weiweiweiopen/IVcurve_tester/hardware/basic/BOM.csv

Designators | Quantity | Value | Footprint | MPN
R12 | 1 | 100 CANDIDATE | Resistor_SMD:R_2512_6332Metric
C1,C2 | 2 | 100n | Capacitor_SMD:C_0603_1608Metric
R20,R21,R22,R23,R24 | 5 | 10k | Resistor_SMD:R_0603_1608Metric
C3 | 1 | 10n | Capacitor_SMD:C_0603_1608Metric
C4,C5 | 2 | 10u 10V X7R | Capacitor_SMD:C_0805_2012Metric
R11 | 1 | 150 CANDIDATE | Resistor_SMD:R_2512_6332Metric
R1 | 1 | 1M CANDIDATE | Resistor_SMD:R_2512_6332Metric
R17 | 1 | 1k | Resistor_SMD:R_0603_1608Metric
R6 | 1 | 1k CANDIDATE | Resistor_SMD:R_2512_6332Metric
R5 | 1 | 2.2k CANDIDATE | Resistor_SMD:R_2512_6332Metric
R16 | 1 | 20 CANDIDATE | Resistor_SMD:R_2512_6332Metric
R2 | 1 | 20k CANDIDATE | Resistor_SMD:R_2512_6332Metric
R10 | 1 | 220 CANDIDATE | Resistor_SMD:R_2512_6332Metric
R15 | 1 | 30.1 CANDIDATE | Resistor_SMD:R_2512_6332Metric
R9 | 1 | 330 CANDIDATE | Resistor_SMD:R_2512_6332Metric
R4 | 1 | 4.3k CANDIDATE | Resistor_SMD:R_2512_6332Metric
R18,R19 | 2 | 4.7k | Resistor_SMD:R_0603_1608Metric
R8 | 1 | 470 CANDIDATE | Resistor_SMD:R_2512_6332Metric
R14 | 1 | 49.9 CANDIDATE | Resistor_SMD:R_2512_6332Metric
R13 | 1 | 75 CANDIDATE | Resistor_SMD:R_2512_6332Metric
R7 | 1 | 750 CANDIDATE | Resistor_SMD:R_2512_6332Metric
R3 | 1 | 8.2k CANDIDATE | Resistor_SMD:R_2512_6332Metric
U1 | 1 | ADG706BRUZ-REEL7 | Package_SO:TSSOP-28_4.4x9.7mm_P0.65mm | ADG706BRUZ-REEL7
U2 | 1 | ADS1115IDGSR / 0x48 | Package_SO:TSSOP-10_3x3mm_P0.5mm | ADS1115IDGSR
J3 | 1 | Adafruit 4814 SSD1680 250x122 | Marc:Adafruit_4814_FeatherWing_Mating | 4814
J1 | 1 | DSSC single-cell collector | Marc:DSSC_Collector_58mm
A1 | 1 | LOLIN S3 Mini V1.0.0 | Marc:LOLIN_S3_MINI_V1 | LOLIN S3 MINI V1.0.0
SW1 | 1 | MEASURE / SCALE | Button_Switch_SMD:SW_SPST_TL3342 | TL3342候選
