weiweiweiopen/IVcurve_tester/hardware/charging/BOM.csv

Designators | Quantity | Value | Footprint | MPN
C201,C202 | 2 | 1.5F 5V PHB | solar_oracle:PHB_5R0V155_R_LaidDown_Provisional | PHB-5R0V155-R
R283 | 1 | 1.74M | Resistor_SMD:R_1206_3216Metric | TNPW12061M74BEEA
R12 | 1 | 100 CANDIDATE | Resistor_SMD:R_2512_6332Metric
R285,R310,R323 | 3 | 100k | Resistor_SMD:R_0603_1608Metric | RC0603FR-07100KL
C1,C2 | 2 | 100n | Capacitor_SMD:C_0603_1608Metric
C314,C334,C335,C336 | 4 | 100n | Capacitor_SMD:C_0805_2012Metric | GRM21BR71H104KA01L
C309,C310 | 2 | 100u | Capacitor_SMD:C_1210_3225Metric | GRM32ER60J107ME20L
R318 | 1 | 107k | Resistor_SMD:R_0603_1608Metric | RC0603FR-07107KL
R20,R21,R22,R23,R24 | 5 | 10k | Resistor_SMD:R_0603_1608Metric
R322,R320,R321 | 3 | 10k | Resistor_SMD:R_0603_1608Metric | RC0603FR-0710KL
C3 | 1 | 10n | Capacitor_SMD:C_0603_1608Metric
C305,C306,C307,C308,C313 | 5 | 10u | Capacitor_SMD:C_0805_2012Metric | GRM21BR61C106KE15L
C4,C5 | 2 | 10u 10V X7R | Capacitor_SMD:C_0805_2012Metric
L202 | 1 | 10uH | Inductor_SMD:L_TDK_MLZ1608 | MLZ1608N100LT000
R319 | 1 | 124k | Resistor_SMD:R_0603_1608Metric | RC0603FR-07124KL
R282 | 1 | 143k | Resistor_SMD:R_1206_3216Metric | TNPW1206143KBEEA
R11 | 1 | 150 CANDIDATE | Resistor_SMD:R_2512_6332Metric
R311 | 1 | 1M | Resistor_SMD:R_0603_1608Metric | RC0603FR-071ML
R1 | 1 | 1M CANDIDATE | Resistor_SMD:R_2512_6332Metric
D201 | 1 | 1N4148W / FLYBACK | Diode_SMD:D_SOD-123 | 1N4148W-7-F
R17 | 1 | 1k | Resistor_SMD:R_0603_1608Metric
R290 | 1 | 1k | Resistor_SMD:R_0603_1608Metric | RC0603FR-071KL
R6 | 1 | 1k CANDIDATE | Resistor_SMD:R_2512_6332Metric
C332,C333 | 2 | 1u | Capacitor_SMD:C_0805_2012Metric | GRM21BR71C105KA01L
C317 | 1 | 1uF 10V X7R | Capacitor_SMD:C_0603_1608Metric | TBD_1uF_10V_X7R_0603
L203 | 1 | 1uH | solar_oracle:Coilcraft_XEL4030 | XEL4030-102MEC
R5 | 1 | 2.2k CANDIDATE | Resistor_SMD:R_2512_6332Metric
R2 | 1 | 20k CANDIDATE | Resistor_SMD:R_2512_6332Metric
R10 | 1 | 220 CANDIDATE | Resistor_SMD:R_2512_6332Metric
C312 | 1 | 220p | Capacitor_SMD:C_0603_1608Metric | GRM1885C1H221JA01D
C304,C311,C315,C316 | 4 | 22u | Capacitor_SMD:C_1210_3225Metric | GRM32ER61A226KE20L
L201 | 1 | 22uH | Inductor_SMD:L_Coilcraft_LPS4018 | LPS4018-223MRC
R9 | 1 | 330 CANDIDATE | Resistor_SMD:R_2512_6332Metric
R4 | 1 | 4.3k CANDIDATE | Resistor_SMD:R_2512_6332Metric
R18,R19 | 2 | 4.7k | Resistor_SMD:R_0603_1608Metric
R8 | 1 | 470 CANDIDATE | Resistor_SMD:R_2512_6332Metric
R291,R286 | 2 | 47k | Resistor_SMD:R_0603_1608Metric | RC0603FR-0747KL
R280 | 1 | 549k | Resistor_SMD:R_1206_3216Metric | TNPW1206549KBEEA
R16 | 1 | 56 CANDIDATE | Resistor_SMD:R_2512_6332Metric
R15 | 1 | 62 CANDIDATE | Resistor_SMD:R_2512_6332Metric
R14 | 1 | 68 CANDIDATE | Resistor_SMD:R_2512_6332Metric
R284 | 1 | 732k | Resistor_SMD:R_0603_1608Metric | RC0603FR-07732KL
R13 | 1 | 75 CANDIDATE | Resistor_SMD:R_2512_6332Metric
R7 | 1 | 750 CANDIDATE | Resistor_SMD:R_2512_6332Metric
R3 | 1 | 8.2k CANDIDATE | Resistor_SMD:R_2512_6332Metric
R281 | 1 | 9.31k | Resistor_SMD:R_1206_3216Metric | TNPW12069K31BEEA
U1 | 1 | ADG706BRUZ-REEL7 | Package_SO:TSSOP-28_4.4x9.7mm_P0.65mm | ADG706BRUZ-REEL7
U2 | 1 | ADS1115IDGSR / 0x48 | Package_SO:TSSOP-10_3x3mm_P0.5mm | ADS1115IDGSR
U207 | 1 | AEM10941 / CFG=000 | solar_oracle:AEM10941_QFN28_EP3.5 | 10AEM10941C0001
Q217 | 1 | AO3400A / RELAY COIL | Package_TO_SOT_SMD:SOT-23 | AO3400A
Q218 | 1 | AO3400A / WARN LEVEL | Package_TO_SOT_SMD:SOT-23 | AO3400A
J3 | 1 | Adafruit 4814 SSD1680 250x122 | Marc:Adafruit_4814_FeatherWing_Mating | 4814
JP201 | 1 | C&K OS102011MA1QN1 | Button_Switch_THT:SW_Slide_SPDT_Angled_CK_OS102011MA1Q | OS102011MA1QN1
J1 | 1 | DSSC single-cell collector | Marc:DSSC_Collector_58mm
K1 | 1 | G6K-2F-Y DC5 | solar_oracle:G6K_2F_Y | G6K-2F-Y-TR DC5
A1 | 1 | LOLIN S3 Mini V1.0.0 | Marc:LOLIN_S3_MINI_V1 | LOLIN S3 MINI V1.0.0
SW1 | 1 | MEASURE / SCALE | Button_Switch_SMD:SW_SPST_TL3342 | TL3342候選
U213 | 1 | SN74LVC1G17DCKR / DONE ISOLATION | Package_TO_SOT_SMD:SOT-353_SC-70-5 | SN74LVC1G17DCKR
U212 | 1 | SN74LVC1G97DCKR / SCHMITT AND | Package_TO_SOT_SMD:SOT-363_SC-70-6 | SN74LVC1G97DCKR
U211 | 1 | TPL5111DDCR / 600s | Package_TO_SOT_SMD:SOT-23-6 | TPL5111DDCR
U214 | 1 | TPS22917DBV | Package_TO_SOT_SMD:SOT-23-6 | TPS22917DBVR
U208 | 1 | TPS61023DRLR / 5V | Package_TO_SOT_SMD:SOT-563 | TPS61023DRLR
U210 | 1 | TPS7A0233PDBVR / AON ONLY | Package_TO_SOT_SMD:SOT-23-5 | TPS7A0233PDBVR
