weiweiweiopen/IVcurve_tester/hardware/basic/checks/pin-map.csv

Reference | Pin | Net
C3 | 1 | ADC_IN
R17 | 2 | ADC_IN
U2 | 4 | ADC_IN
A1 | J3.4 | BUTTON_N
R21 | 2 | BUTTON_N
SW1 | 1 | BUTTON_N
J1 | 1 | DUT_P
R1 | 1 | DUT_P
R10 | 1 | DUT_P
R11 | 1 | DUT_P
R12 | 1 | DUT_P
R13 | 1 | DUT_P
R14 | 1 | DUT_P
R15 | 1 | DUT_P
R16 | 1 | DUT_P
R17 | 1 | DUT_P
R2 | 1 | DUT_P
R3 | 1 | DUT_P
R4 | 1 | DUT_P
R5 | 1 | DUT_P
R6 | 1 | DUT_P
R7 | 1 | DUT_P
R8 | 1 | DUT_P
R9 | 1 | DUT_P
A1 | J4.2 | EPD_CS
J3 | 21 | EPD_CS
R23 | 2 | EPD_CS
A1 | J4.3 | EPD_DC
J3 | 22 | EPD_DC
A1 | J3.7 | GND
A1 | J4.7 | GND
C1 | 2 | GND
C2 | 2 | GND
C3 | 2 | GND
C4 | 2 | GND
C5 | 2 | GND
J1 | 2 | GND
J3 | 4 | GND
R20 | 2 | GND
SW1 | 2 | GND
U1 | 12 | GND
U1 | 27 | GND
U1 | 28 | GND
U2 | 1 | GND
U2 | 3 | GND
U2 | 5 | GND
U2 | 6 | GND
U2 | 7 | GND
A1 | J5.7 | I2C_SCL
R19 | 2 | I2C_SCL
U2 | 10 | I2C_SCL
A1 | J5.6 | I2C_SDA
R18 | 2 | I2C_SDA
U2 | 9 | I2C_SDA
R1 | 2 | LOAD_00
U1 | 19 | LOAD_00
R2 | 2 | LOAD_01
U1 | 20 | LOAD_01
R3 | 2 | LOAD_02
U1 | 21 | LOAD_02
R4 | 2 | LOAD_03
U1 | 22 | LOAD_03
R5 | 2 | LOAD_04
U1 | 23 | LOAD_04
R6 | 2 | LOAD_05
U1 | 24 | LOAD_05
R7 | 2 | LOAD_06
U1 | 25 | LOAD_06
R8 | 2 | LOAD_07
U1 | 26 | LOAD_07
R9 | 2 | LOAD_08
U1 | 11 | LOAD_08
R10 | 2 | LOAD_09
U1 | 10 | LOAD_09
R11 | 2 | LOAD_10
U1 | 9 | LOAD_10
R12 | 2 | LOAD_11
U1 | 8 | LOAD_11
R13 | 2 | LOAD_12
U1 | 7 | LOAD_12
R14 | 2 | LOAD_13
U1 | 6 | LOAD_13
R15 | 2 | LOAD_14
U1 | 5 | LOAD_14
R16 | 2 | LOAD_15
U1 | 4 | LOAD_15
A1 | J2.8 | MCU_3V3
C1 | 1 | MCU_3V3
C2 | 1 | MCU_3V3
C4 | 1 | MCU_3V3
J3 | 2 | MCU_3V3
R18 | 1 | MCU_3V3
R19 | 1 | MCU_3V3
R21 | 1 | MCU_3V3
R22 | 1 | MCU_3V3
R23 | 1 | MCU_3V3
R24 | 1 | MCU_3V3
U1 | 1 | MCU_3V3
U2 | 8 | MCU_3V3
A1 | J2.2 | MUX_A0
U1 | 17 | MUX_A0
A1 | J5.4 | MUX_A1
U1 | 16 | MUX_A1
A1 | J2.3 | MUX_A2
U1 | 15 | MUX_A2
A1 | J5.3 | MUX_A3
U1 | 14 | MUX_A3
A1 | J5.8 | MUX_EN
R20 | 1 | MUX_EN
U1 | 18 | MUX_EN
J3 | 19 | SD_CS_N
R22 | 2 | SD_CS_N
A1 | J3.5 | SPI_MISO
J3 | 13 | SPI_MISO
A1 | J3.6 | SPI_MOSI
J3 | 12 | SPI_MOSI
A1 | J3.3 | SPI_SCK
J3 | 11 | SPI_SCK
A1 | J4.4 | SRAM_CS
J3 | 20 | SRAM_CS
R24 | 2 | SRAM_CS
A1 | J3.8 | USB_5V
C5 | 1 | USB_5V
A1 | J2.1 | unconnected-(A1-EN-PadJ2.1)
A1 | J5.1 | unconnected-(A1-GPIO1-PadJ5.1)
A1 | J5.2 | unconnected-(A1-GPIO3-PadJ5.2)
A1 | J5.5 | unconnected-(A1-GPIO7-PadJ5.5)
A1 | J2.7 | unconnected-(A1-GPIO10-PadJ2.7)
A1 | J2.6 | unconnected-(A1-GPIO11-PadJ2.6)
A1 | J2.4 | unconnected-(A1-GPIO12-PadJ2.4)
A1 | J2.5 | unconnected-(A1-GPIO13-PadJ2.5)
A1 | J4.8 | unconnected-(A1-GPIO15-PadJ4.8)
A1 | J4.6 | unconnected-(A1-GPIO17-PadJ4.6)
A1 | J4.5 | unconnected-(A1-GPIO21-PadJ4.5)
A1 | J4.1 | unconnected-(A1-GPIO33-PadJ4.1)
A1 | J3.1 | unconnected-(A1-GPIO43-PadJ3.1)
A1 | J3.2 | unconnected-(A1-GPIO44-PadJ3.2)
J3 | 5 | unconnected-(J3-A0-Pad5)
J3 | 6 | unconnected-(J3-A1-Pad6)
J3 | 7 | unconnected-(J3-A2-Pad7)
J3 | 8 | unconnected-(J3-A3-Pad8)
J3 | 9 | unconnected-(J3-A4-Pad9)
J3 | 10 | unconnected-(J3-A5-Pad10)
J3 | 3 | unconnected-(J3-AREF-Pad3)
J3 | 23 | unconnected-(J3-D11-Pad23)
J3 | 24 | unconnected-(J3-D12-Pad24)
J3 | 25 | unconnected-(J3-D13-Pad25)
J3 | 27 | unconnected-(J3-EN_NC-Pad27)
J3 | 16 | unconnected-(J3-GPIO-Pad16)
J3 | 1 | unconnected-(J3-RESET_AUTO-Pad1)
J3 | 14 | unconnected-(J3-RX-Pad14)
J3 | 18 | unconnected-(J3-SCL-Pad18)
J3 | 17 | unconnected-(J3-SDA-Pad17)
J3 | 15 | unconnected-(J3-TX-Pad15)
J3 | 26 | unconnected-(J3-USB_NC-Pad26)
J3 | 28 | unconnected-(J3-VBAT_NC-Pad28)
U1 | 2 | unconnected-(U1-NC-Pad2)
U1 | 3 | unconnected-(U1-NC-Pad3)
U1 | 13 | unconnected-(U1-NC-Pad13)
U2 | 2 | unconnected-(U2-ALERT_RDY-Pad2)
