weiweiweiopen/IVcurve_tester/hardware/charging/checks/pin-map.csv

Reference | Pin | Net
C3 | 1 | ADC_IN
R17 | 2 | ADC_IN
U2 | 4 | ADC_IN
C333 | 1 | AON_3V3
C334 | 1 | AON_3V3
C335 | 1 | AON_3V3
C336 | 1 | AON_3V3
U210 | 5 | AON_3V3
U211 | 1 | AON_3V3
U211 | 6 | AON_3V3
U212 | 5 | AON_3V3
U213 | 5 | AON_3V3
R322 | 1 | BOOST_EN
U208 | 2 | BOOST_EN
U212 | 4 | BOOST_EN
A1 | J3.4 | BUTTON_N
R21 | 2 | BUTTON_N
SW1 | 1 | BUTTON_N
J1 | 1 | DUT_P
K1 | 3 | DUT_P
K1 | 6 | DUT_P
A1 | J4.2 | EPD_CS
J3 | 21 | EPD_CS
R23 | 2 | EPD_CS
A1 | J4.3 | EPD_DC
J3 | 22 | EPD_DC
A1 | J3.7 | GND
A1 | J4.7 | GND
C1 | 2 | GND
C2 | 2 | GND
C201 | 2 | GND
C202 | 2 | GND
C3 | 2 | GND
C304 | 2 | GND
C305 | 2 | GND
C306 | 2 | GND
C307 | 2 | GND
C308 | 2 | GND
C309 | 2 | GND
C310 | 2 | GND
C311 | 2 | GND
C313 | 2 | GND
C314 | 2 | GND
C315 | 2 | GND
C316 | 2 | GND
C317 | 2 | GND
C332 | 2 | GND
C333 | 2 | GND
C334 | 2 | GND
C335 | 2 | GND
C336 | 2 | GND
C4 | 2 | GND
C5 | 2 | GND
J1 | 2 | GND
J3 | 4 | GND
JP201 | 3 | GND
Q217 | 2 | GND
Q218 | 2 | GND
R20 | 2 | GND
R280 | 2 | GND
R285 | 2 | GND
R286 | 2 | GND
R291 | 2 | GND
R311 | 2 | GND
R318 | 2 | GND
R319 | 2 | GND
R320 | 2 | GND
R321 | 2 | GND
R322 | 2 | GND
R323 | 2 | GND
SW1 | 2 | GND
U1 | 12 | GND
U1 | 27 | GND
U1 | 28 | GND
U2 | 1 | GND
U2 | 3 | GND
U2 | 5 | GND
U2 | 6 | GND
U2 | 7 | GND
U207 | 10 | GND
U207 | 12 | GND
U207 | 15 | GND
U207 | 17 | GND
U207 | 18 | GND
U207 | 29 | GND
U207 | 4 | GND
U207 | 5 | GND
U207 | 6 | GND
U207 | 7 | GND
U207 | 8 | GND
U207 | 9 | GND
U208 | 4 | GND
U210 | 2 | GND
U211 | 2 | GND
U212 | 1 | GND
U212 | 2 | GND
U213 | 3 | GND
U214 | 2 | GND
K1 | 2 | HARV_P
U207 | 25 | HARV_P
U207 | 26 | HARV_P
A1 | J5.7 | I2C_SCL
R19 | 2 | I2C_SCL
U2 | 10 | I2C_SCL
A1 | J5.6 | I2C_SDA
R18 | 2 | I2C_SDA
U2 | 9 | I2C_SDA
R1 | 2 | LOAD_00
U1 | 19 | LOAD_00
R2 | 2 | LOAD_01
U1 | 20 | LOAD_01
R3 | 2 | LOAD_02
U1 | 21 | LOAD_02
R4 | 2 | LOAD_03
U1 | 22 | LOAD_03
R5 | 2 | LOAD_04
U1 | 23 | LOAD_04
R6 | 2 | LOAD_05
U1 | 24 | LOAD_05
R7 | 2 | LOAD_06
U1 | 25 | LOAD_06
R8 | 2 | LOAD_07
U1 | 26 | LOAD_07
R9 | 2 | LOAD_08
U1 | 11 | LOAD_08
R10 | 2 | LOAD_09
U1 | 10 | LOAD_09
R11 | 2 | LOAD_10
U1 | 9 | LOAD_10
R12 | 2 | LOAD_11
U1 | 8 | LOAD_11
R13 | 2 | LOAD_12
U1 | 7 | LOAD_12
R14 | 2 | LOAD_13
U1 | 6 | LOAD_13
R15 | 2 | LOAD_14
U1 | 5 | LOAD_14
R16 | 2 | LOAD_15
U1 | 4 | LOAD_15
K1 | 4 | LOAD_P
R1 | 1 | LOAD_P
R10 | 1 | LOAD_P
R11 | 1 | LOAD_P
R12 | 1 | LOAD_P
R13 | 1 | LOAD_P
R14 | 1 | LOAD_P
R15 | 1 | LOAD_P
R16 | 1 | LOAD_P
R2 | 1 | LOAD_P
R3 | 1 | LOAD_P
R4 | 1 | LOAD_P
R5 | 1 | LOAD_P
R6 | 1 | LOAD_P
R7 | 1 | LOAD_P
R8 | 1 | LOAD_P
R9 | 1 | LOAD_P
A1 | J2.8 | MCU_3V3
C1 | 1 | MCU_3V3
C2 | 1 | MCU_3V3
C4 | 1 | MCU_3V3
J3 | 2 | MCU_3V3
R18 | 1 | MCU_3V3
R19 | 1 | MCU_3V3
R21 | 1 | MCU_3V3
R22 | 1 | MCU_3V3
R23 | 1 | MCU_3V3
R24 | 1 | MCU_3V3
R310 | 2 | MCU_3V3
U1 | 1 | MCU_3V3
U2 | 8 | MCU_3V3
A1 | J2.5 | MCU_DONE
R320 | 1 | MCU_DONE
U213 | 2 | MCU_DONE
A1 | J3.8 | MODULE_VBUS
C5 | 1 | MODULE_VBUS
D201 | 1 | MODULE_VBUS
K1 | 1 | MODULE_VBUS
U214 | 6 | MODULE_VBUS
A1 | J2.2 | MUX_A0
U1 | 17 | MUX_A0
A1 | J5.4 | MUX_A1
U1 | 16 | MUX_A1
A1 | J2.3 | MUX_A2
U1 | 15 | MUX_A2
A1 | J5.3 | MUX_A3
U1 | 14 | MUX_A3
A1 | J5.8 | MUX_EN
R20 | 1 | MUX_EN
U1 | 18 | MUX_EN
C312 | 2 | P5_FB
R284 | 2 | P5_FB
R285 | 1 | P5_FB
U208 | 1 | P5_FB
L203 | 2 | P5_SW
U208 | 5 | P5_SW
C304 | 1 | PM_BOOST
R283 | 1 | PM_BOOST
U207 | 1 | PM_BOOST
C306 | 1 | PM_BUCK
L202 | 2 | PM_BUCK
U207 | 3 | PM_BUCK
C305 | 1 | PM_BUFSRC
L201 | 1 | PM_BUFSRC
U207 | 27 | PM_BUFSRC
C308 | 1 | PM_HVOUT
U207 | 14 | PM_HVOUT
C307 | 1 | PM_LVOUT
U207 | 11 | PM_LVOUT
R286 | 1 | PM_READY
U207 | 21 | PM_READY
U212 | 3 | PM_READY
L201 | 2 | PM_SWBOOST
U207 | 28 | PM_SWBOOST
L202 | 1 | PM_SWBUCK
U207 | 2 | PM_SWBUCK
Q218 | 1 | PM_WARN
R311 | 1 | PM_WARN
U207 | 20 | PM_WARN
A1 | J2.6 | POWER_WARN_N
Q218 | 3 | POWER_WARN_N
R310 | 1 | POWER_WARN_N
D201 | 2 | RELAY_COIL_LOW
K1 | 8 | RELAY_COIL_LOW
Q217 | 3 | RELAY_COIL_LOW
Q217 | 1 | SCAN_GATE
R290 | 2 | SCAN_GATE
R291 | 1 | SCAN_GATE
A1 | J2.4 | SCAN_MODE
R290 | 1 | SCAN_MODE
J3 | 19 | SD_CS_N
R22 | 2 | SD_CS_N
K1 | 5 | SENSE_P
R17 | 1 | SENSE_P
R281 | 1 | SET_CHRDY
R282 | 2 | SET_CHRDY
U207 | 23 | SET_CHRDY
R280 | 1 | SET_OVCH
R281 | 2 | SET_OVCH
U207 | 22 | SET_OVCH
R282 | 1 | SET_OVDIS
R283 | 2 | SET_OVDIS
U207 | 24 | SET_OVDIS
C312 | 1 | SOLAR_5V
C315 | 1 | SOLAR_5V
C316 | 1 | SOLAR_5V
C317 | 1 | SOLAR_5V
JP201 | 1 | SOLAR_5V
R284 | 1 | SOLAR_5V
R323 | 1 | SOLAR_5V
U208 | 6 | SOLAR_5V
U214 | 1 | SOLAR_5V
JP201 | 2 | SOLAR_EN
U214 | 3 | SOLAR_EN
A1 | J3.5 | SPI_MISO
J3 | 13 | SPI_MISO
A1 | J3.6 | SPI_MOSI
J3 | 12 | SPI_MOSI
A1 | J3.3 | SPI_SCK
J3 | 11 | SPI_SCK
A1 | J4.4 | SRAM_CS
J3 | 20 | SRAM_CS
R24 | 2 | SRAM_CS
R318 | 1 | TIMER_DELAY
R319 | 1 | TIMER_DELAY
U211 | 3 | TIMER_DELAY
R321 | 1 | TIMER_DONE
U211 | 4 | TIMER_DONE
U213 | 4 | TIMER_DONE
U211 | 5 | TIMER_REQUEST
U212 | 6 | TIMER_REQUEST
C201 | 1 | VSTORE
C202 | 1 | VSTORE
C309 | 1 | VSTORE
C310 | 1 | VSTORE
C311 | 1 | VSTORE
C313 | 1 | VSTORE
C314 | 1 | VSTORE
C332 | 1 | VSTORE
L203 | 1 | VSTORE
U207 | 16 | VSTORE
U208 | 3 | VSTORE
U210 | 1 | VSTORE
U210 | 3 | VSTORE
A1 | J2.1 | unconnected-(A1-EN-PadJ2.1)
A1 | J5.1 | unconnected-(A1-GPIO1-PadJ5.1)
A1 | J5.2 | unconnected-(A1-GPIO3-PadJ5.2)
A1 | J5.5 | unconnected-(A1-GPIO7-PadJ5.5)
A1 | J2.7 | unconnected-(A1-GPIO10-PadJ2.7)
A1 | J4.8 | unconnected-(A1-GPIO15-PadJ4.8)
A1 | J4.6 | unconnected-(A1-GPIO17-PadJ4.6)
A1 | J4.5 | unconnected-(A1-GPIO21-PadJ4.5)
A1 | J4.1 | unconnected-(A1-GPIO33-PadJ4.1)
A1 | J3.1 | unconnected-(A1-GPIO43-PadJ3.1)
A1 | J3.2 | unconnected-(A1-GPIO44-PadJ3.2)
J3 | 5 | unconnected-(J3-A0-Pad5)
J3 | 6 | unconnected-(J3-A1-Pad6)
J3 | 7 | unconnected-(J3-A2-Pad7)
J3 | 8 | unconnected-(J3-A3-Pad8)
J3 | 9 | unconnected-(J3-A4-Pad9)
J3 | 10 | unconnected-(J3-A5-Pad10)
J3 | 3 | unconnected-(J3-AREF-Pad3)
J3 | 23 | unconnected-(J3-D11-Pad23)
J3 | 24 | unconnected-(J3-D12-Pad24)
J3 | 25 | unconnected-(J3-D13-Pad25)
J3 | 27 | unconnected-(J3-EN_NC-Pad27)
J3 | 16 | unconnected-(J3-GPIO-Pad16)
J3 | 1 | unconnected-(J3-RESET_AUTO-Pad1)
J3 | 14 | unconnected-(J3-RX-Pad14)
J3 | 18 | unconnected-(J3-SCL-Pad18)
J3 | 17 | unconnected-(J3-SDA-Pad17)
J3 | 15 | unconnected-(J3-TX-Pad15)
J3 | 26 | unconnected-(J3-USB_NC-Pad26)
J3 | 28 | unconnected-(J3-VBAT_NC-Pad28)
K1 | 7 | unconnected-(K1-NC_B-Pad7)
U1 | 2 | unconnected-(U1-NC-Pad2)
U1 | 3 | unconnected-(U1-NC-Pad3)
U1 | 13 | unconnected-(U1-NC-Pad13)
U2 | 2 | unconnected-(U2-ALERT_RDY-Pad2)
U207 | 13 | unconnected-(U207-FB_HV-Pad13)
U207 | 19 | unconnected-(U207-STATUS2-Pad19)
U210 | 4 | unconnected-(U210-NC-Pad4)
U213 | 1 | unconnected-(U213-NC-Pad1)
U214 | 4 | unconnected-(U214-CT-Pad4)
U214 | 5 | unconnected-(U214-QOD-Pad5)
