weiweiweiopen/IVcurve_tester/hardware/charging/models/Relay_DPDT_Omron_G6K-2F-Y.step

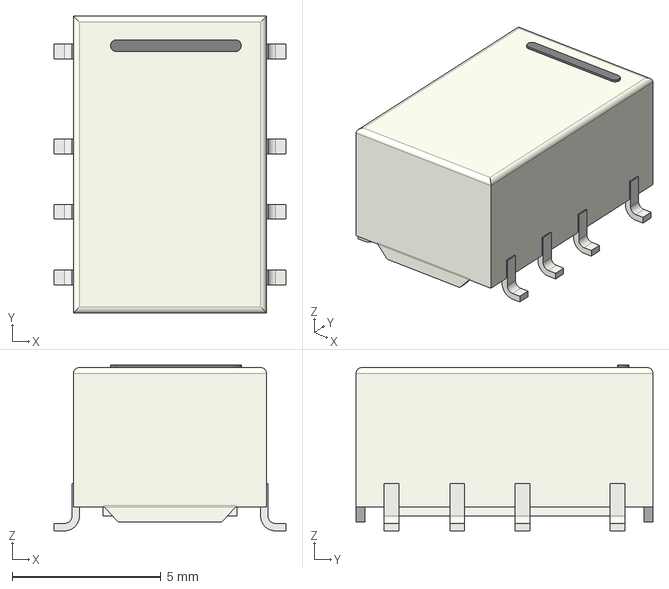
[picture p3: CAD file, 2026-10-28]
hardware/charging/models/Relay_DPDT_Omron_G6K-2F-Y.step
7.80 x 10.0 x 5.58 mm
