weiweiweiopen/IVcurve_tester/firmware/basic/calibration-record.md

# Calibration record — NOT CALIBRATED

No hardware measurements performed. All measuredPathOhms entries remain NAN.
Before changing calibration.h record: instrument and traceability, date, channel, actual total path resistance vs voltage/current/temperature, ADC gain/offset, DUT limits, resistor part/power/tolerance, and verified EN disconnection. No assumed Ron or claimed DUT safe range.
