weiweiweiopen/IVcurve_tester/hardware/basic/schematic.pdf

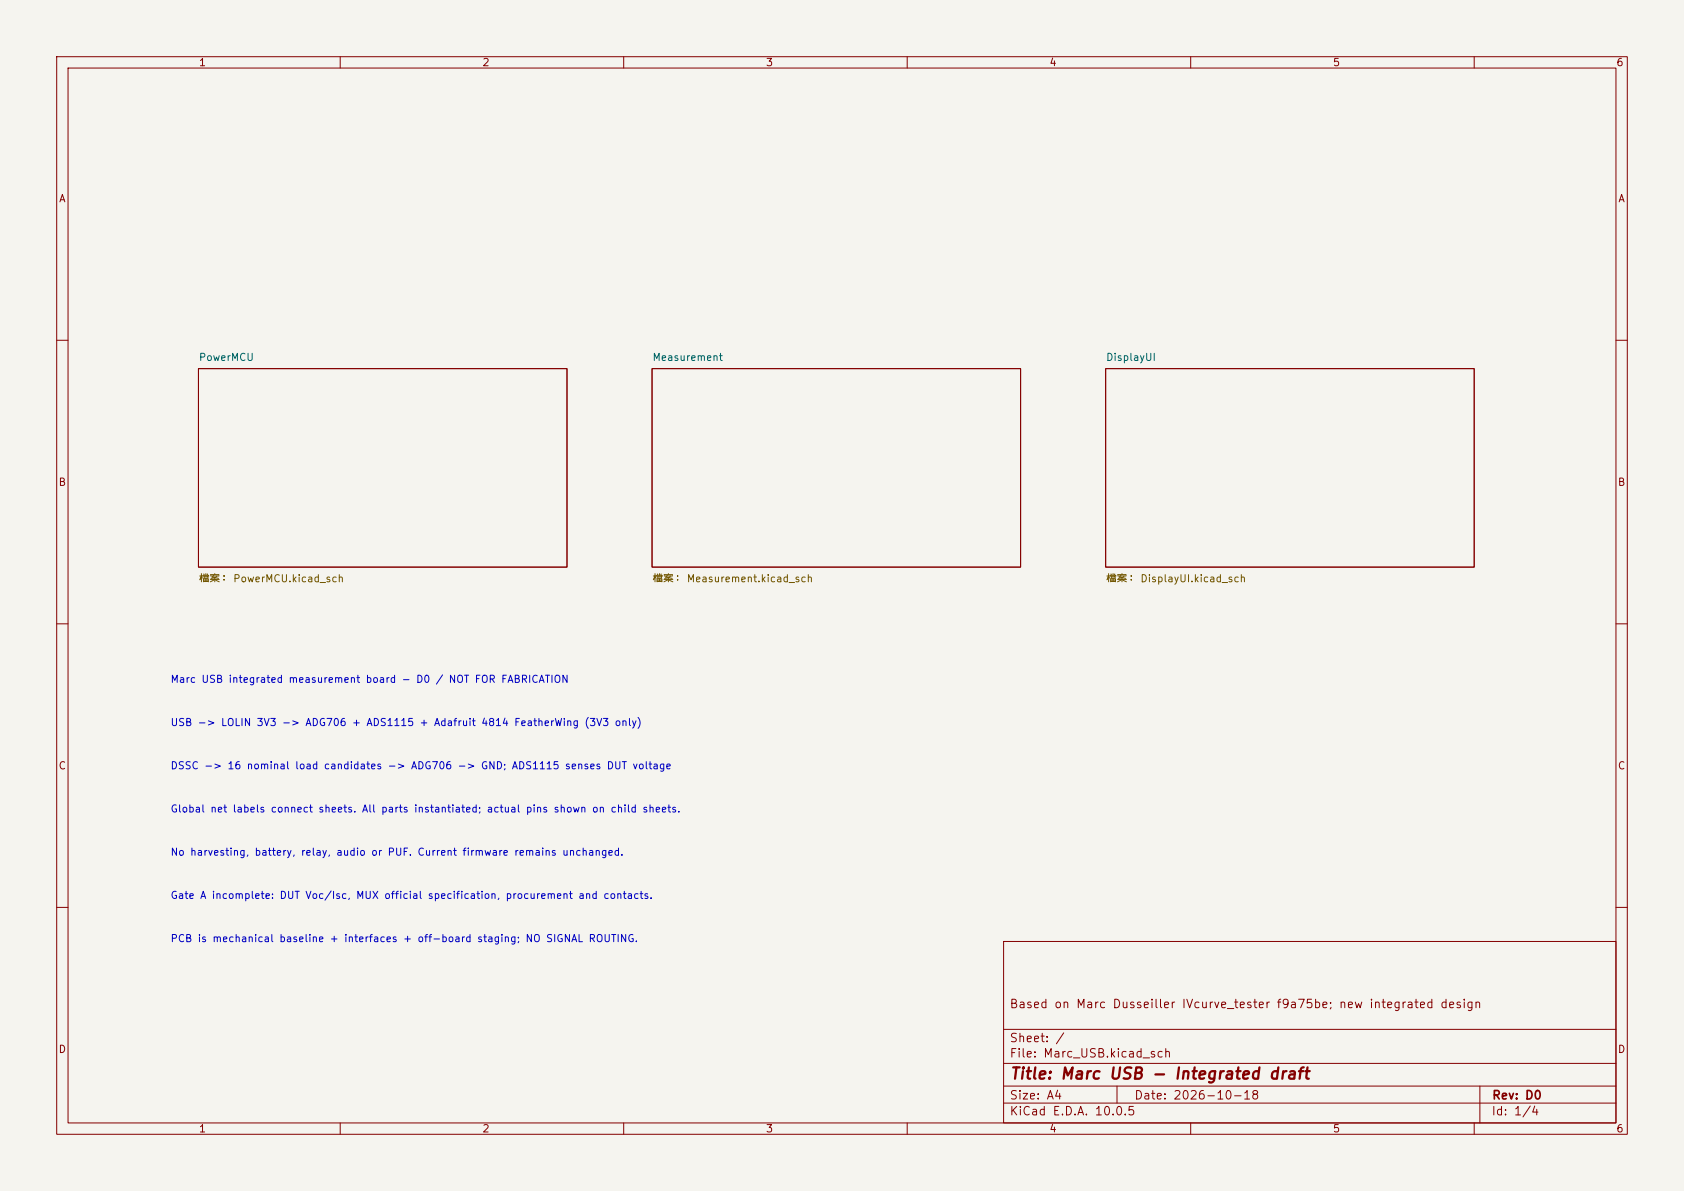
[picture p4: page 1]

檔案： DisplayUI.kicad_sch Measurement 檔案： Measurement.kicad_sch PCB is mechanical baseline + interfaces + off-board staging; NO SIGNAL ROUTING. Global net labels connect sheets. All parts instantiated; actual pins shown on child sheets. Gate A incomplete: DUT Voc/Isc, MUX official specification, procurement and contacts. DSSC -> 16 nominal load candidates -> ADG706 -> GND; ADS1115 senses DUT voltage No harvesting, battery, relay, audio or PUF. Current firmware remains unchanged. Marc USB integrated measurement board - D0 / NOT FOR FABRICATION

USB -> LOLIN 3V3 -> ADG706 + ADS1115 + Adafruit 4814 FeatherWing (3V3 only)

Based on Marc Dusseiller IVcurve_tester f9a75be; new integrated design

Sheet: /
File: Marc_USB.kicad_sch
Title: Marc USB - Integrated draft

Size: A4 | Rev: D0
KiCad E.D.A. 10.0.5 | Id: 1/4

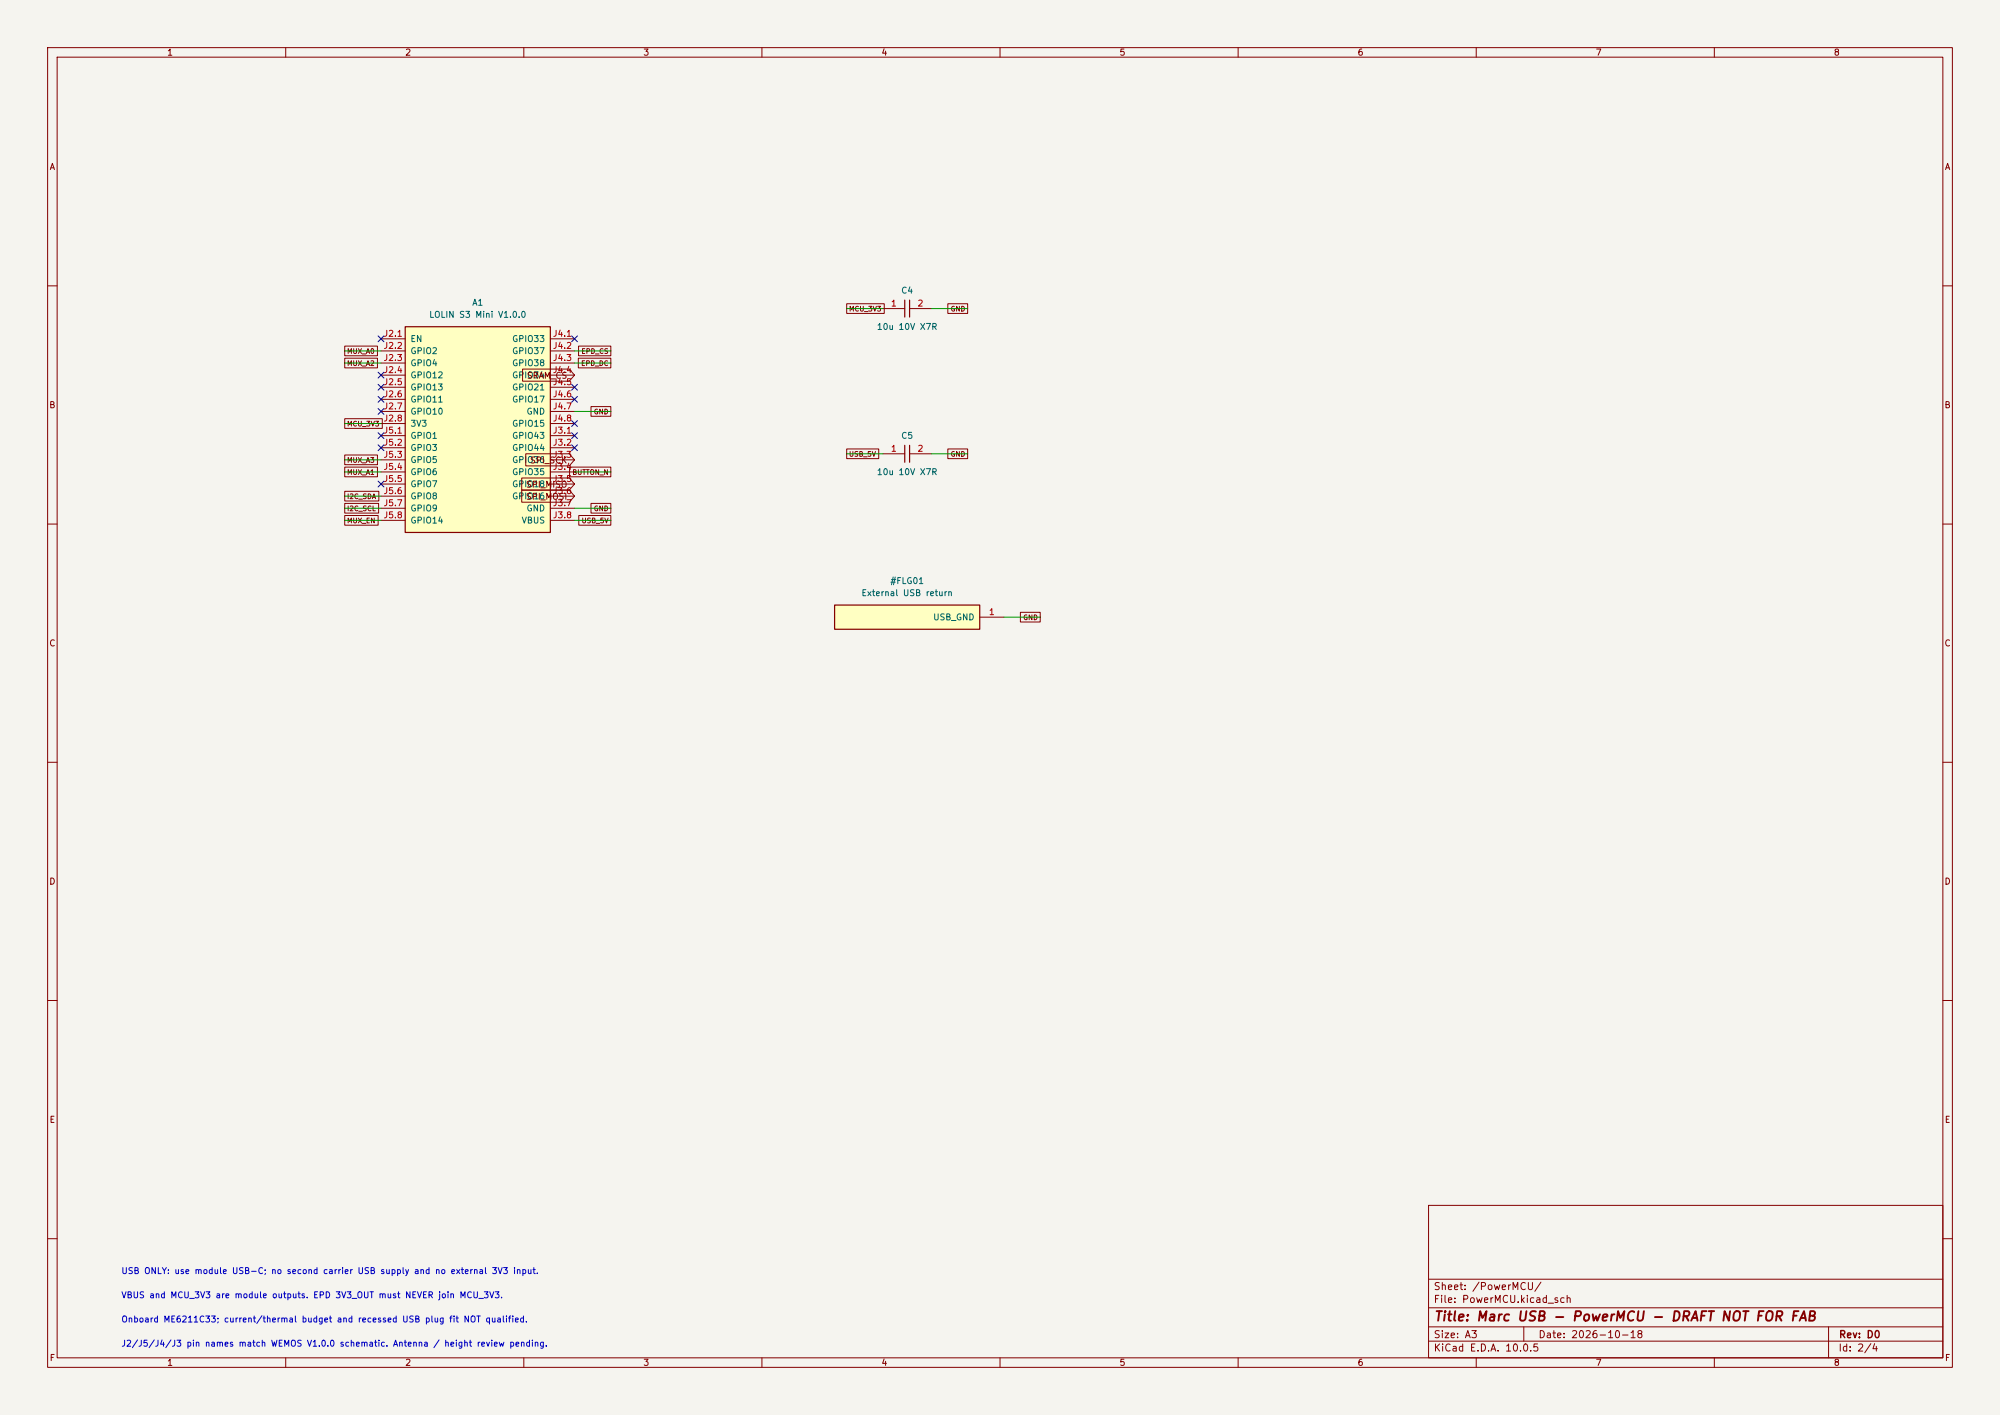
[picture p5: page 2]

VBUS and MCU_3V3 are module outputs. EPD 3V3_OUT must NEVER join MCU_3V3. J2/J5/J4/J3 pin names match WEMOS V1.0.0 schematic. Antenna / height review pending. Onboard ME6211C33; current/thermal budget and recessed USB plug fit NOT qualified. USB ONLY: use module USB-C; no second carrier USB supply and no external 3V3 input.

Sheet: /PowerMCU/
File: PowerMCU.kicad_sch
Title: Marc USB - PowerMCU - DRAFT NOT FOR FAB

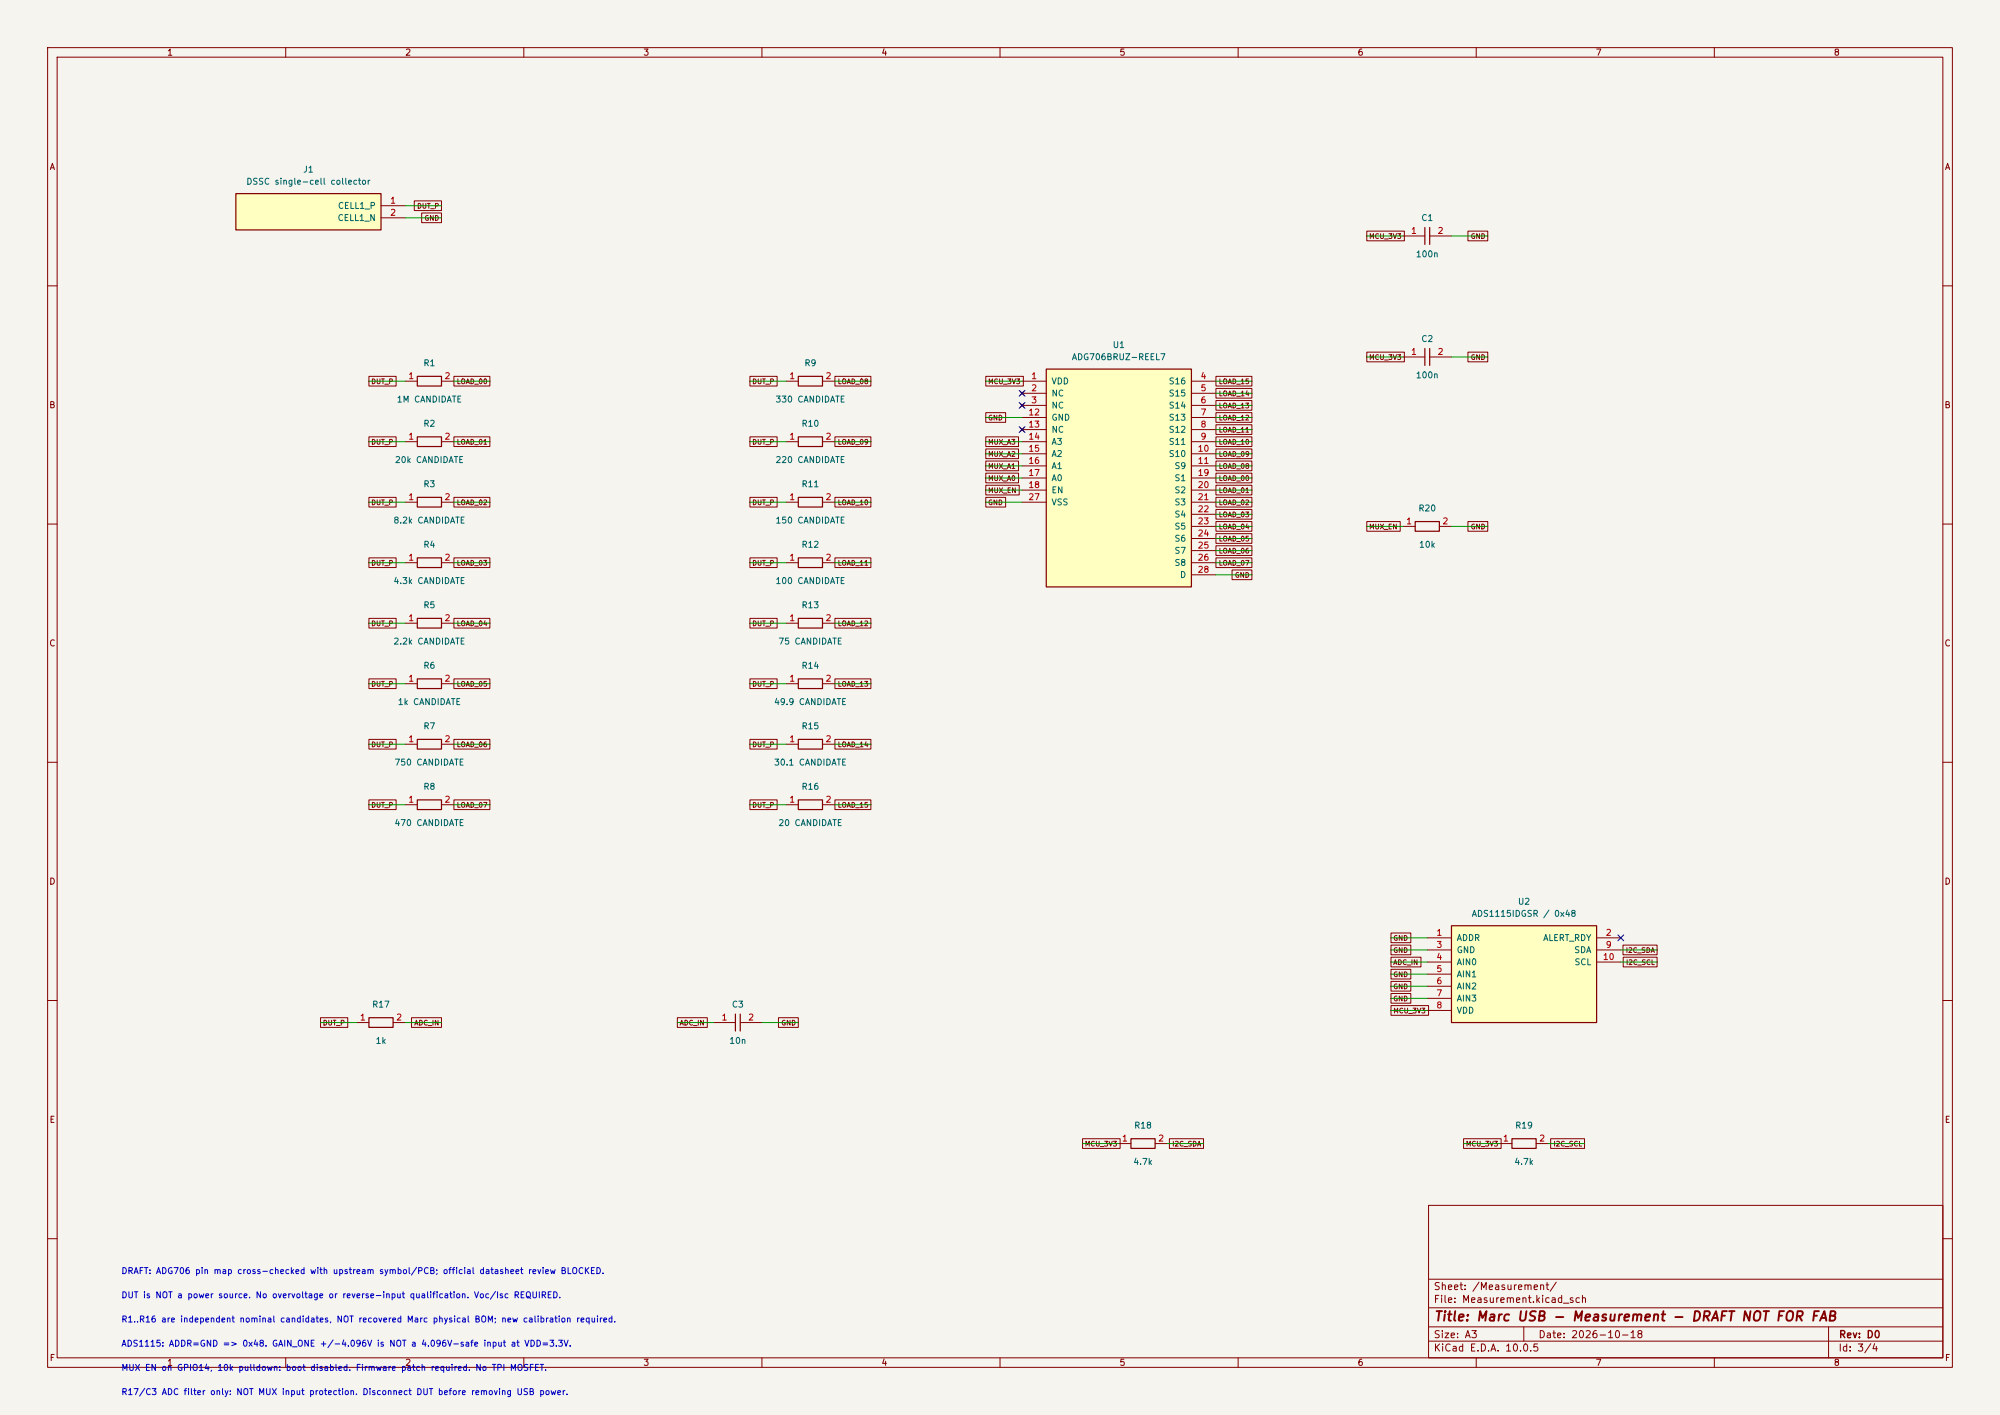
[picture p6: page 3]

J1 DSSC single-cell collector

DUT_P R1..R16 are independent nominal candidates, NOT recovered Marc physical BOM; new calibration required. DRAFT: ADG706 pin map cross-checked with upstream symbol/PCB; official datasheet review BLOCKED. MUX EN on GPIO14, 10k pulldown: boot disabled. Firmware patch required. No TPI MOSFET. ADS1115: ADDR=GND => 0x48. GAIN_ONE +/-4.096V is NOT a 4.096V-safe input at VDD=3.3V. R17/C3 ADC filter only: NOT MUX input protection. Disconnect DUT before removing USB power. DUT is NOT a power source. No overvoltage or reverse-input qualification. Voc/Isc REQUIRED.

Sheet: /Measurement/
File: Measurement.kicad_sch
Title: Marc USB - Measurement - DRAFT NOT FOR FAB

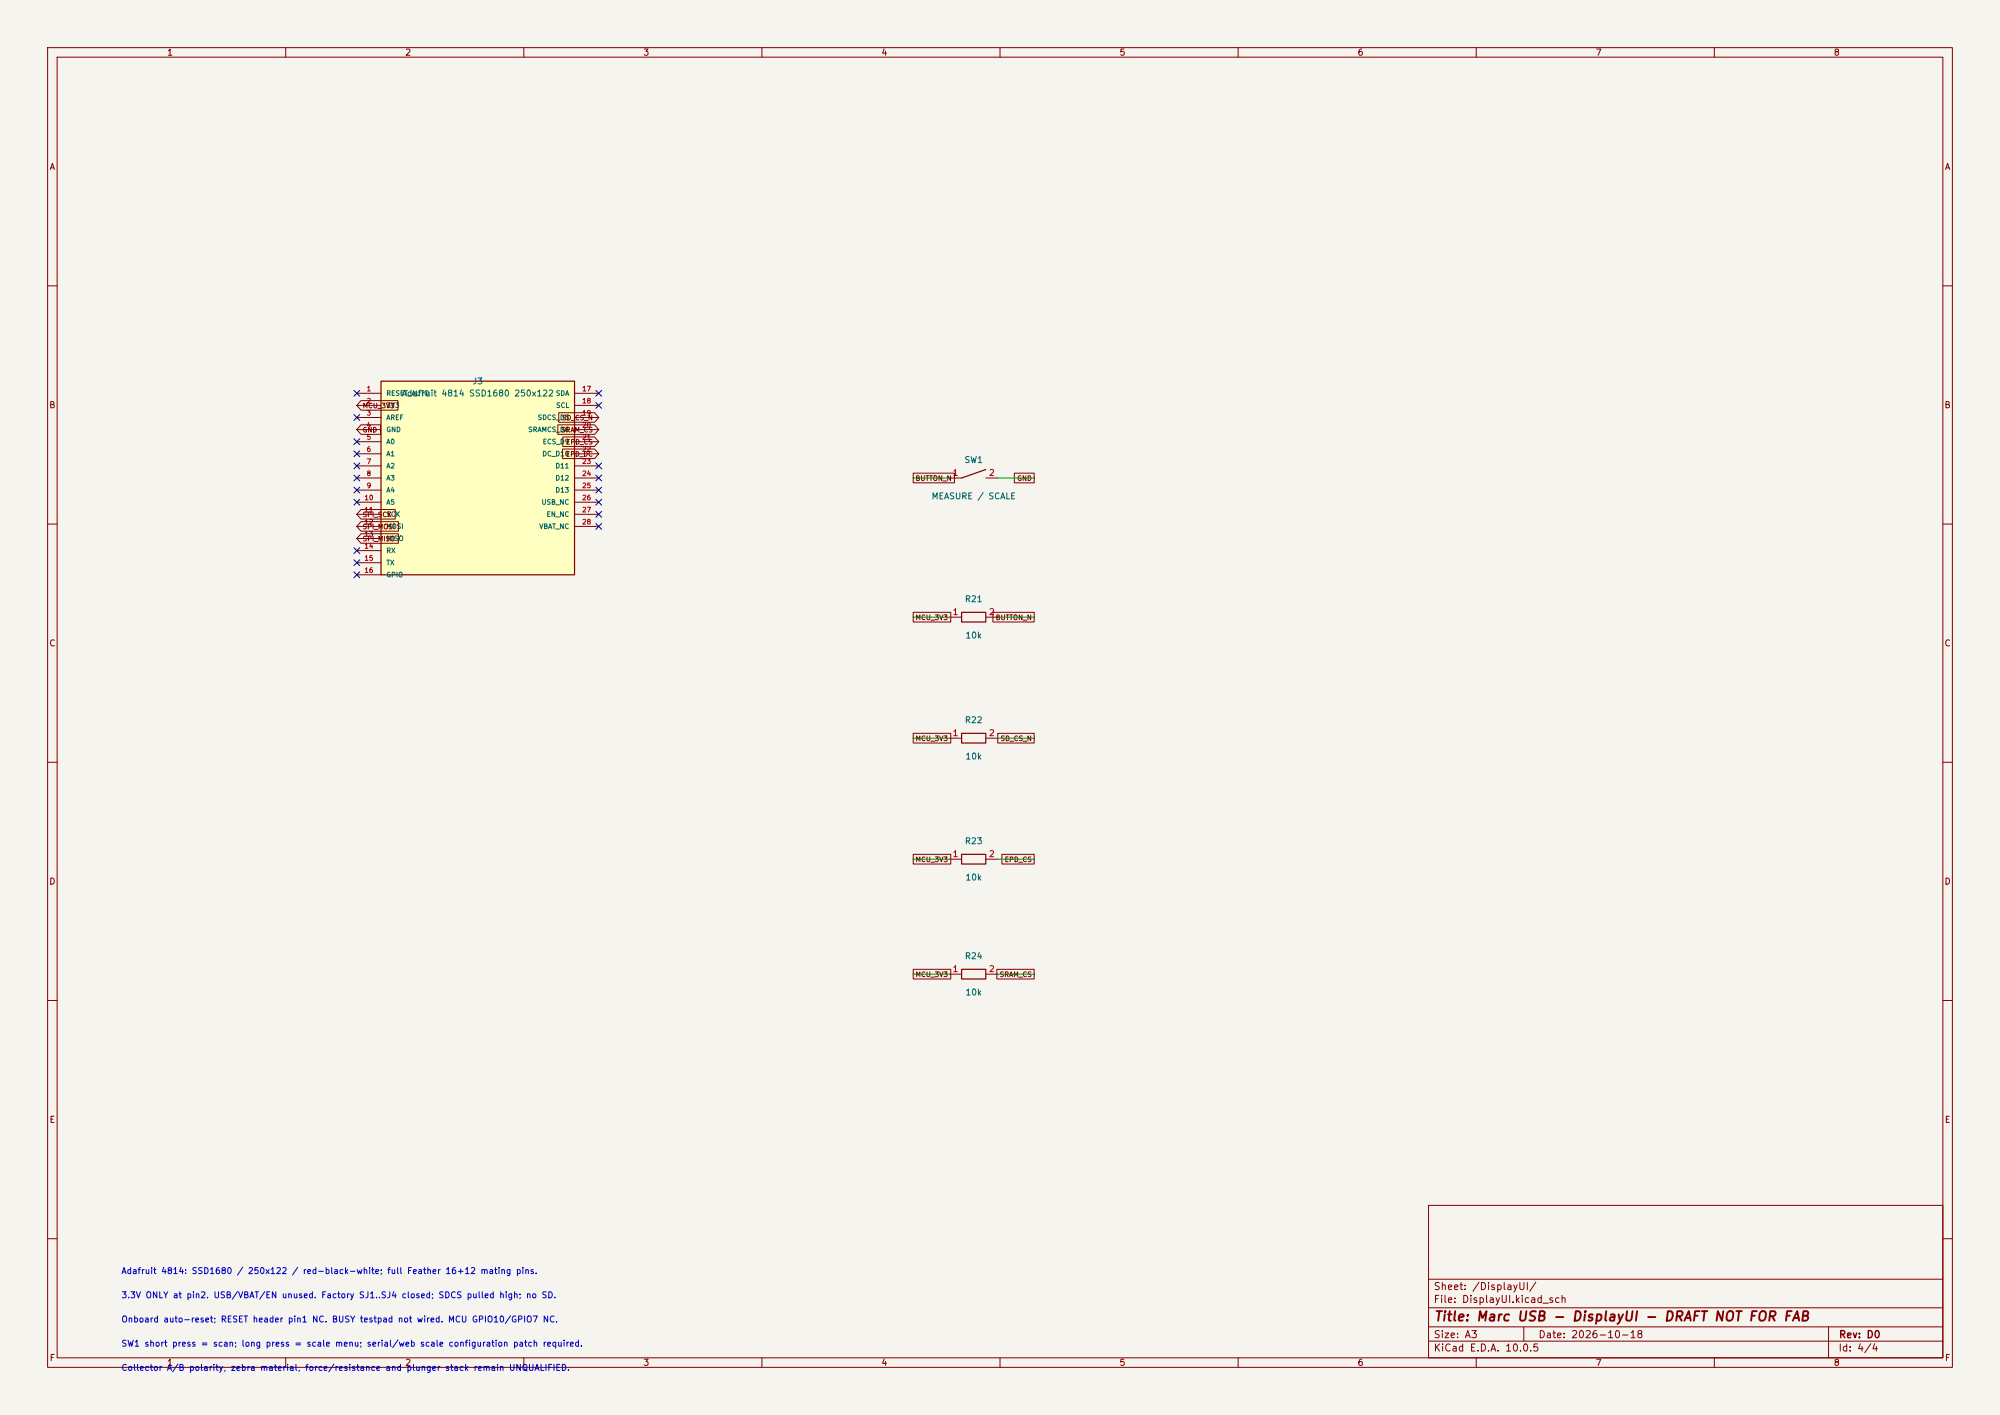
[picture p7: page 4]

SW1 short press = scan; long press = scale menu; serial/web scale configuration patch required. Onboard auto-reset; RESET header pin1 NC. BUSY testpad not wired. MCU GPIO10/GPIO7 NC. Collector A/B polarity, zebra material, force/resistance and plunger stack remain UNQUALIFIED. 3.3V ONLY at pin2. USB/VBAT/EN unused. Factory SJ1..SJ4 closed; SDCS pulled high; no SD. Adafruit 4814: SSD1680 / 250x122 / red-black-white; full Feather 16+12 mating pins.

Sheet: /DisplayUI/
File: DisplayUI.kicad_sch
Title: Marc USB - DisplayUI - DRAFT NOT FOR FAB
