weiweiweiopen/IVcurve_tester/hardware/charging/schematic.pdf

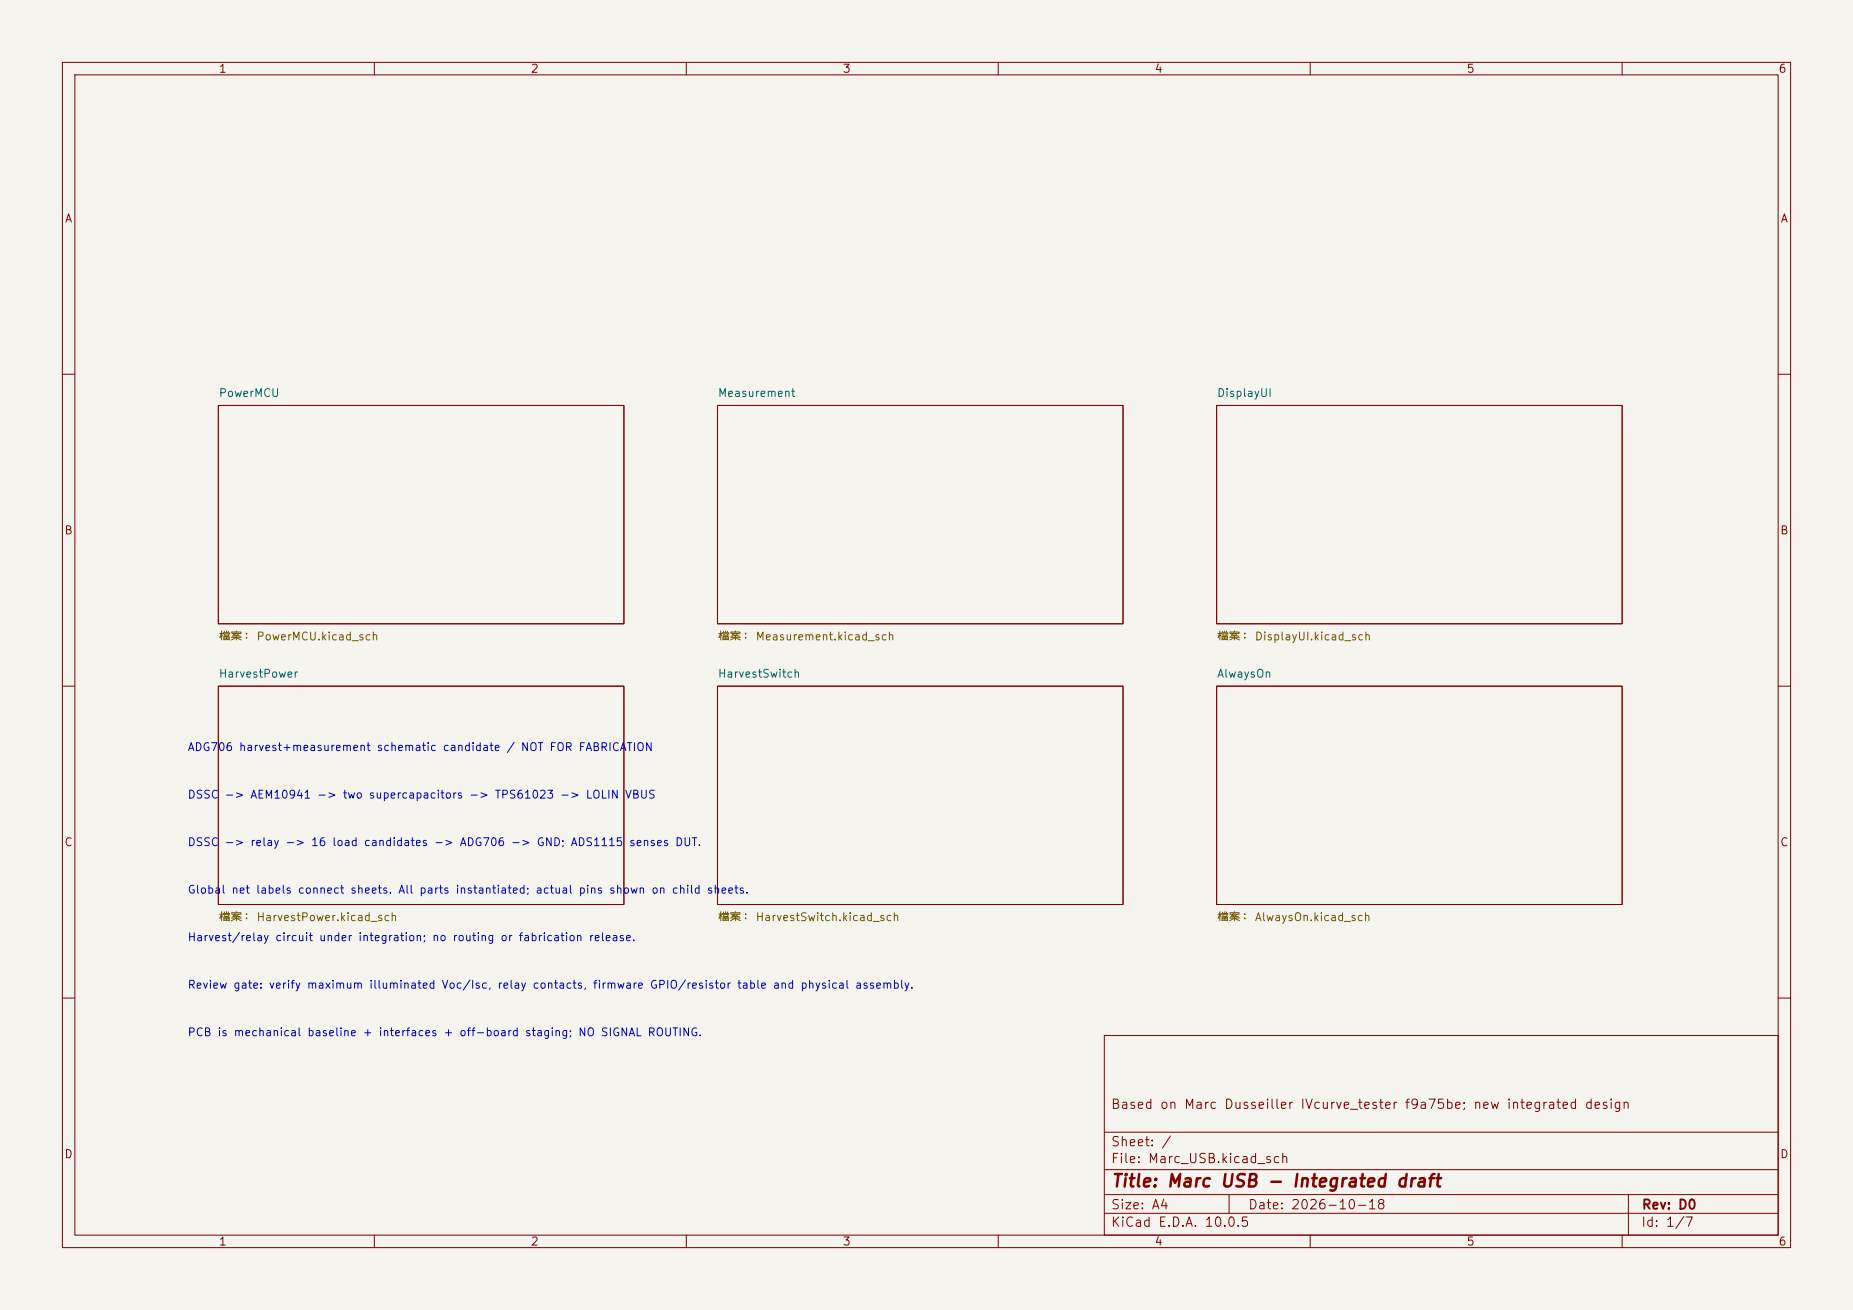
[picture p8: page 1]

檔案： DisplayUI.kicad_sch Measurement 檔案： Measurement.kicad_sch HarvestSwitch 檔案： HarvestSwitch.kicad_sch

Based on Marc Dusseiller IVcurve_tester f9a75be; new integrated design

Sheet: /
File: Marc_USB.kicad_sch
Title: Marc USB - Integrated draft

Size: A4 | Rev: D0
KiCad E.D.A. 10.0.5 | Id: 1/7

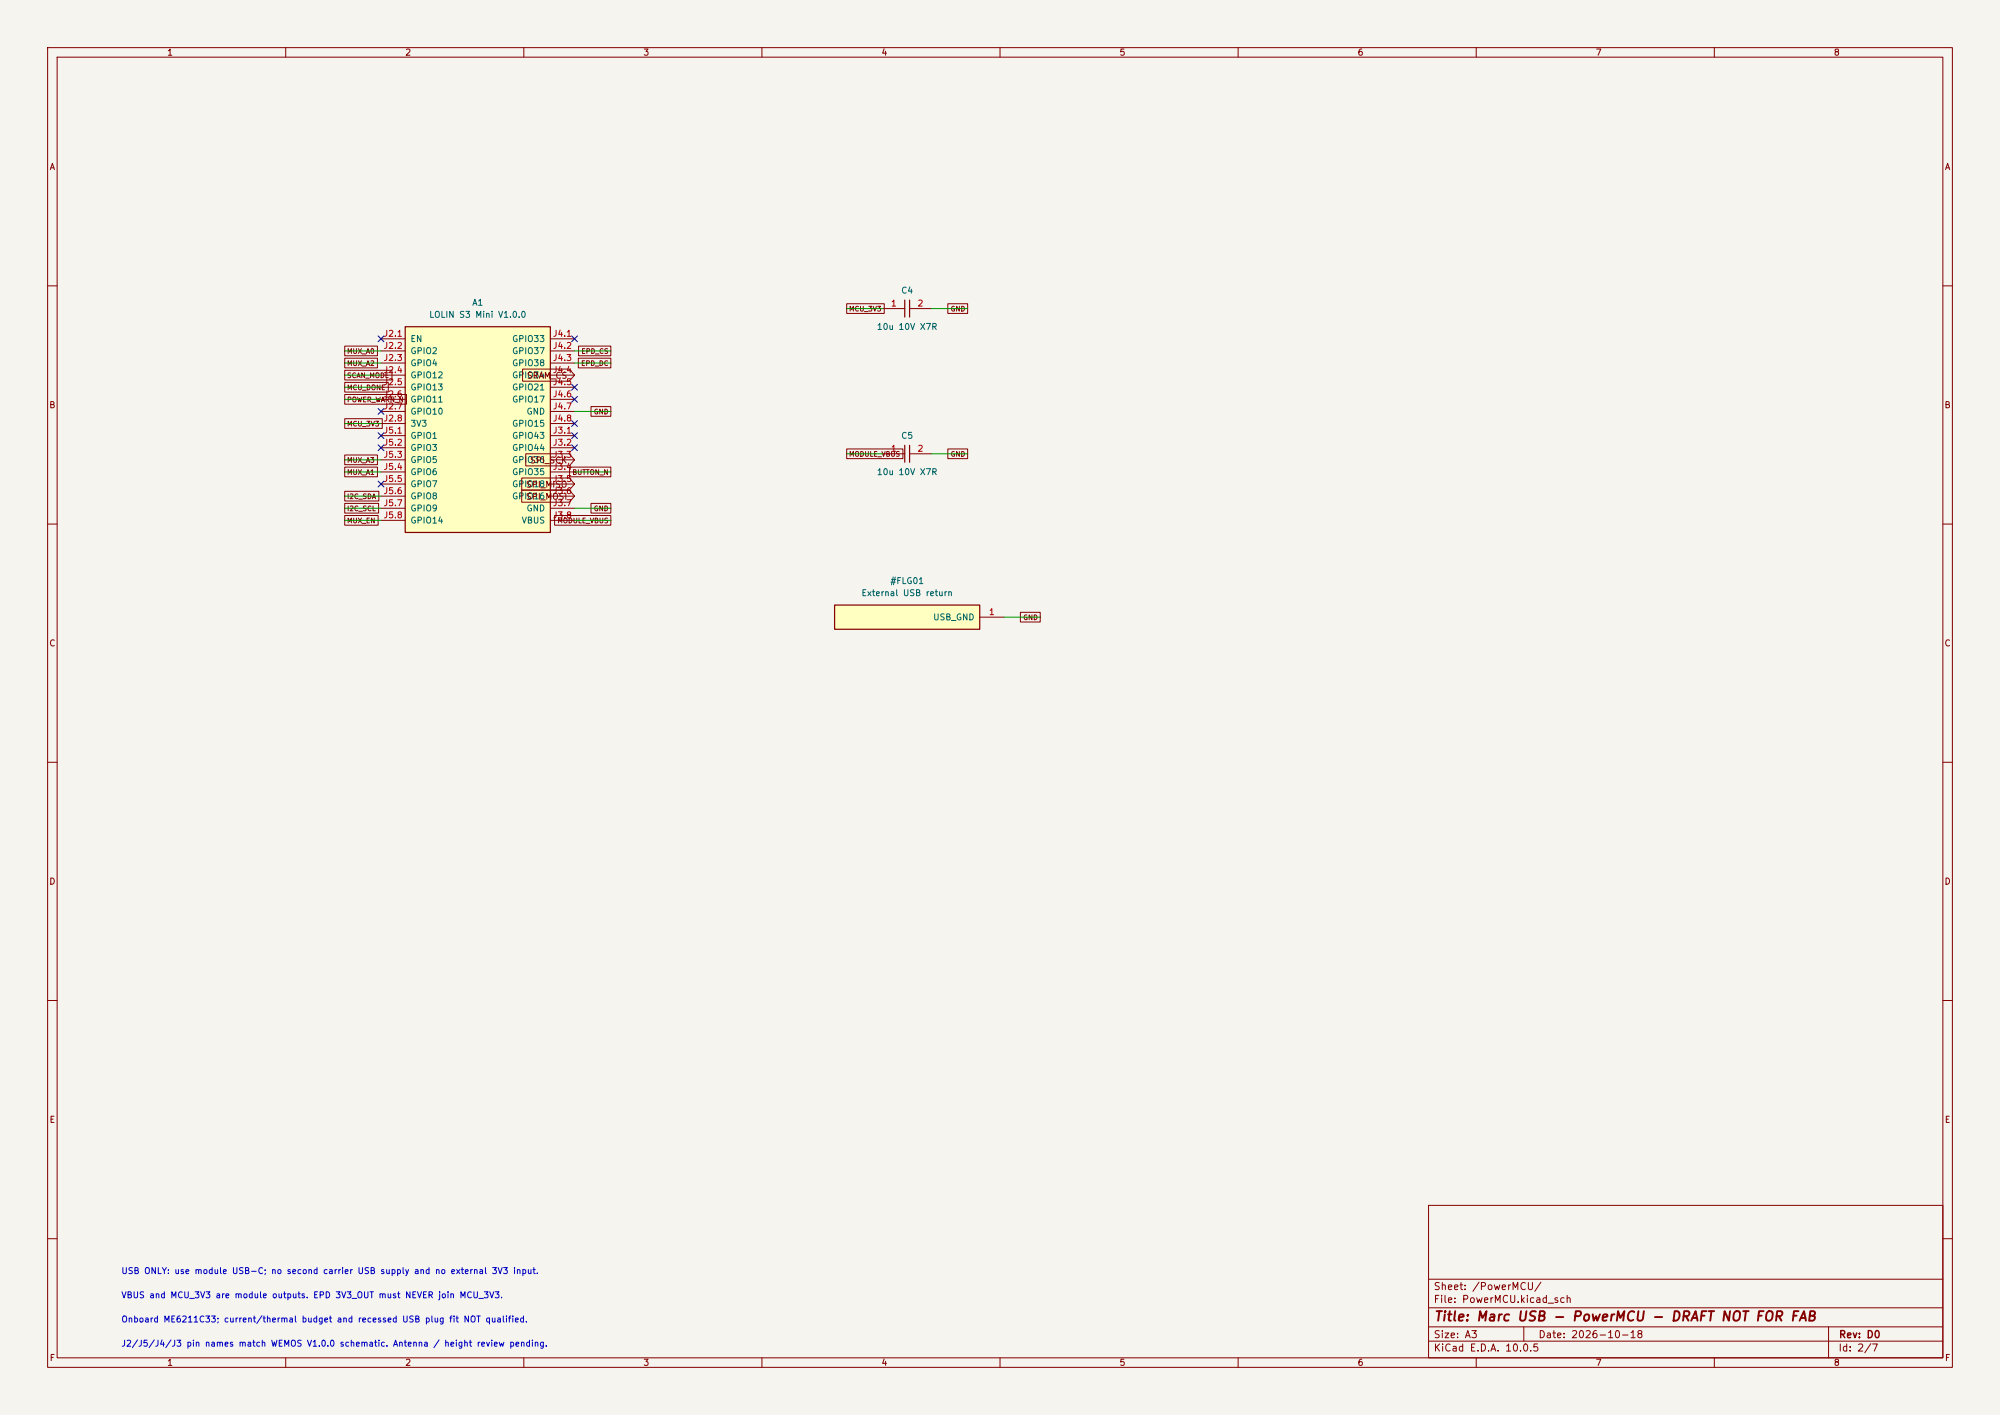
[picture p9: page 2]

VBUS and MCU_3V3 are module outputs. EPD 3V3_OUT must NEVER join MCU_3V3. J2/J5/J4/J3 pin names match WEMOS V1.0.0 schematic. Antenna / height review pending. Onboard ME6211C33; current/thermal budget and recessed USB plug fit NOT qualified. USB ONLY: use module USB-C; no second carrier USB supply and no external 3V3 input.

Sheet: /PowerMCU/
File: PowerMCU.kicad_sch
Title: Marc USB - PowerMCU - DRAFT NOT FOR FAB

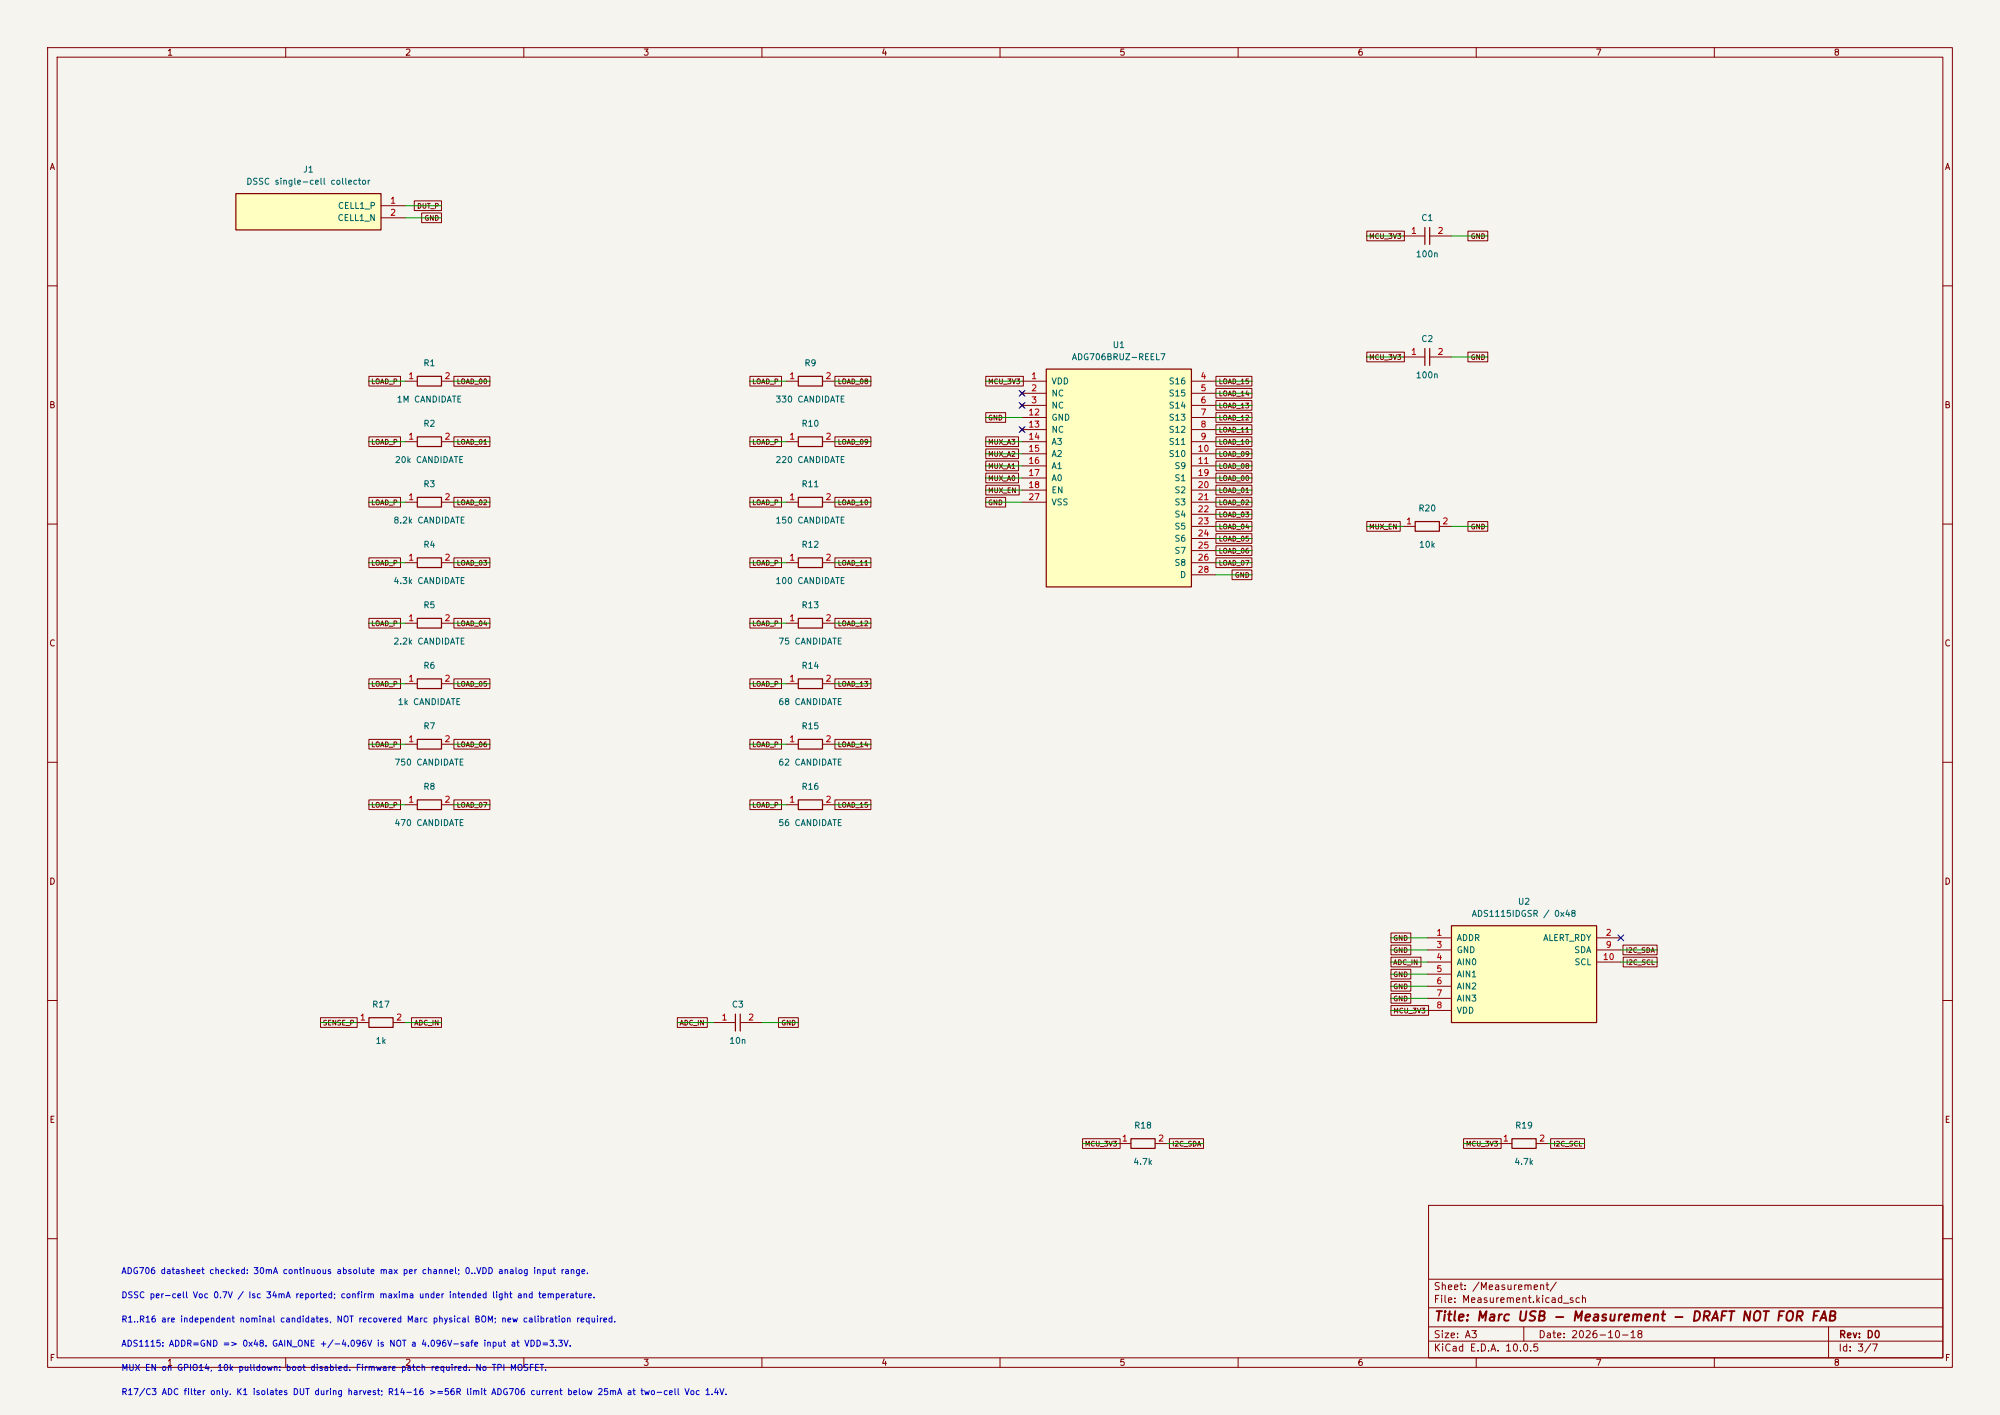
[picture p10: page 3]

J1 DSSC single-cell collector

LOAD_P R1..R16 are independent nominal candidates, NOT recovered Marc physical BOM; new calibration required. ADG706 datasheet checked: 30mA continuous absolute max per channel; 0..VDD analog input range. MUX EN on GPIO14, 10k pulldown: boot disabled. Firmware patch required. No TPI MOSFET. ADS1115: ADDR=GND => 0x48. GAIN_ONE +/-4.096V is NOT a 4.096V-safe input at VDD=3.3V. R17/C3 ADC filter only. K1 isolates DUT during harvest; R14-16 >=56R limit ADG706 current below 25mA at two-cell Voc 1.4V. DSSC per-cell Voc 0.7V / Isc 34mA reported; confirm maxima under intended light and temperature.

Sheet: /Measurement/
File: Measurement.kicad_sch
Title: Marc USB - Measurement - DRAFT NOT FOR FAB

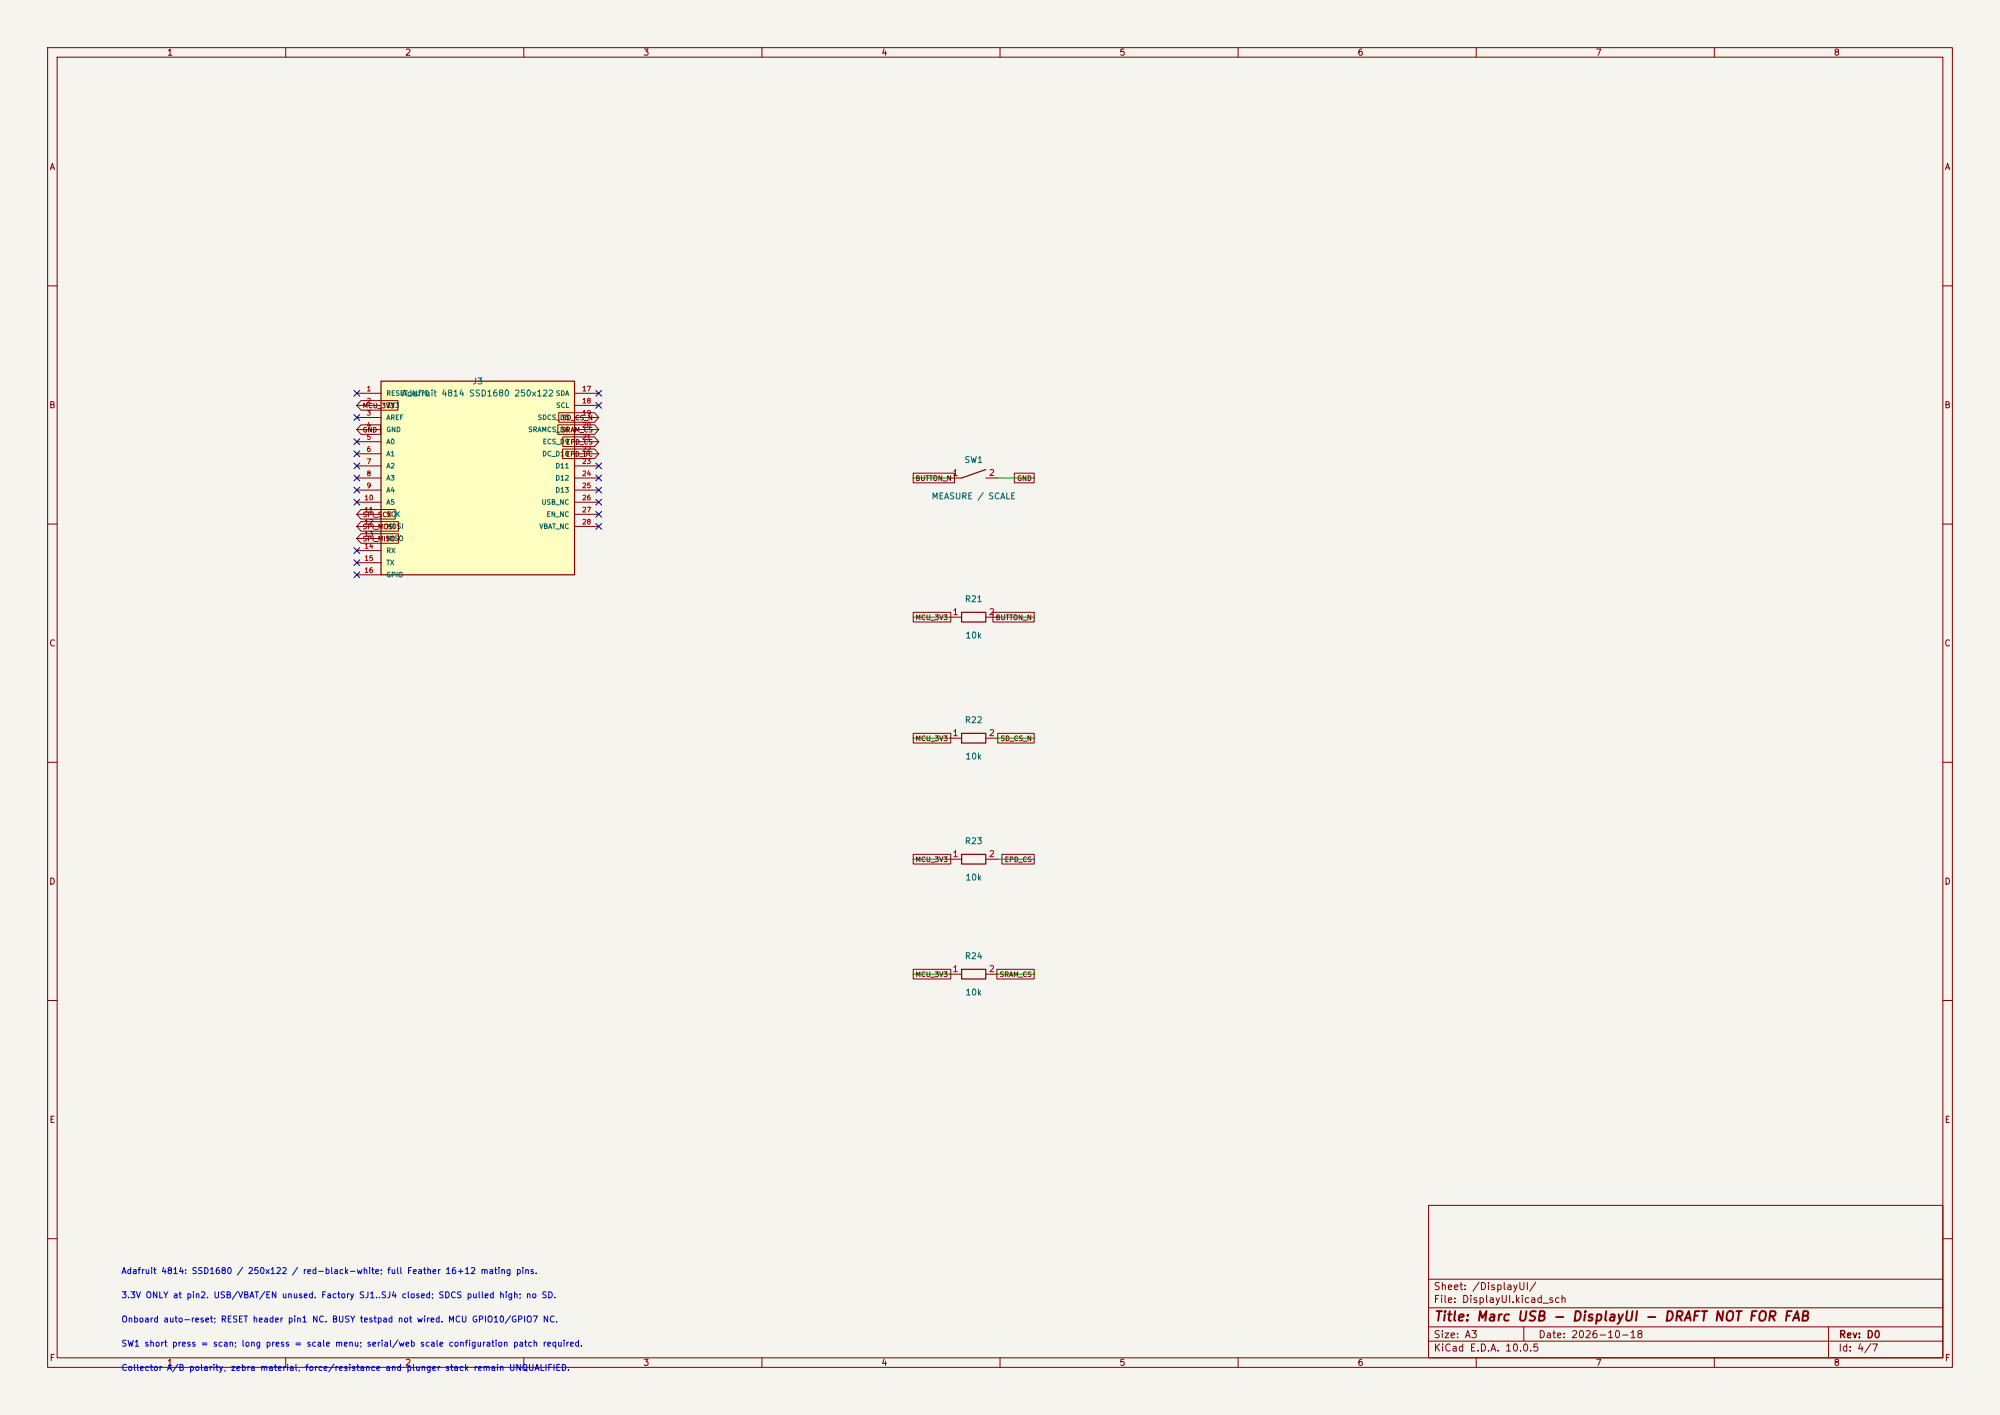
[picture p11: page 4]

SW1 short press = scan; long press = scale menu; serial/web scale configuration patch required. Onboard auto-reset; RESET header pin1 NC. BUSY testpad not wired. MCU GPIO10/GPIO7 NC. Collector A/B polarity, zebra material, force/resistance and plunger stack remain UNQUALIFIED. 3.3V ONLY at pin2. USB/VBAT/EN unused. Factory SJ1..SJ4 closed; SDCS pulled high; no SD. Adafruit 4814: SSD1680 / 250x122 / red-black-white; full Feather 16+12 mating pins.

Sheet: /DisplayUI/
File: DisplayUI.kicad_sch
Title: Marc USB - DisplayUI - DRAFT NOT FOR FAB

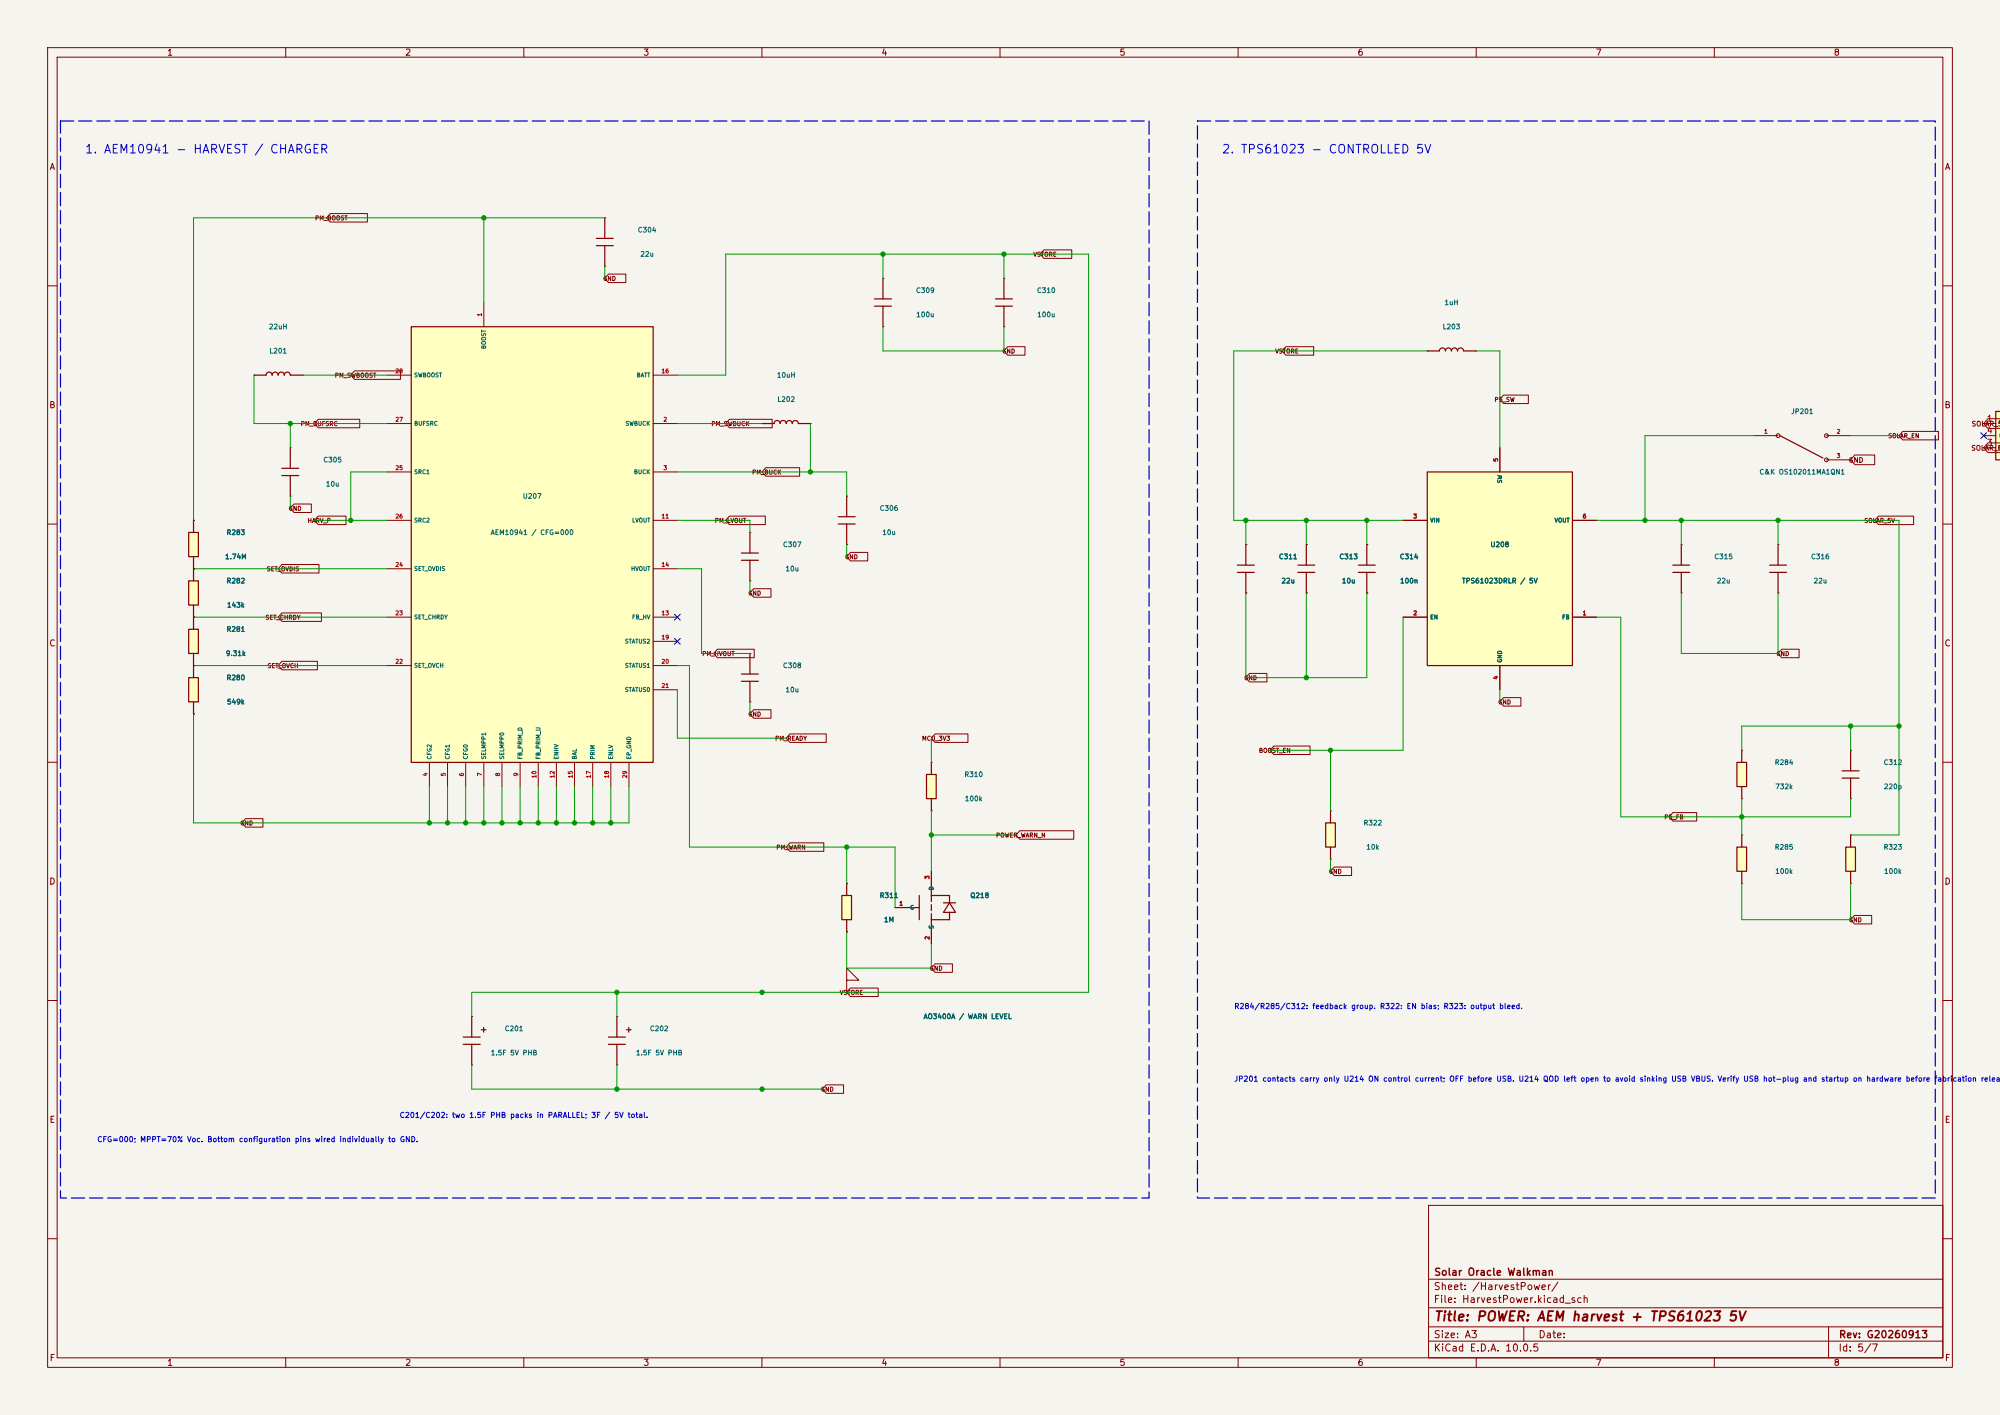
[picture p12: page 5]

Solar Oracle Walkman
Sheet: /HarvestPower/
File: HarvestPower.kicad_sch
Title: POWER: AEM harvest + TPS61023 5V

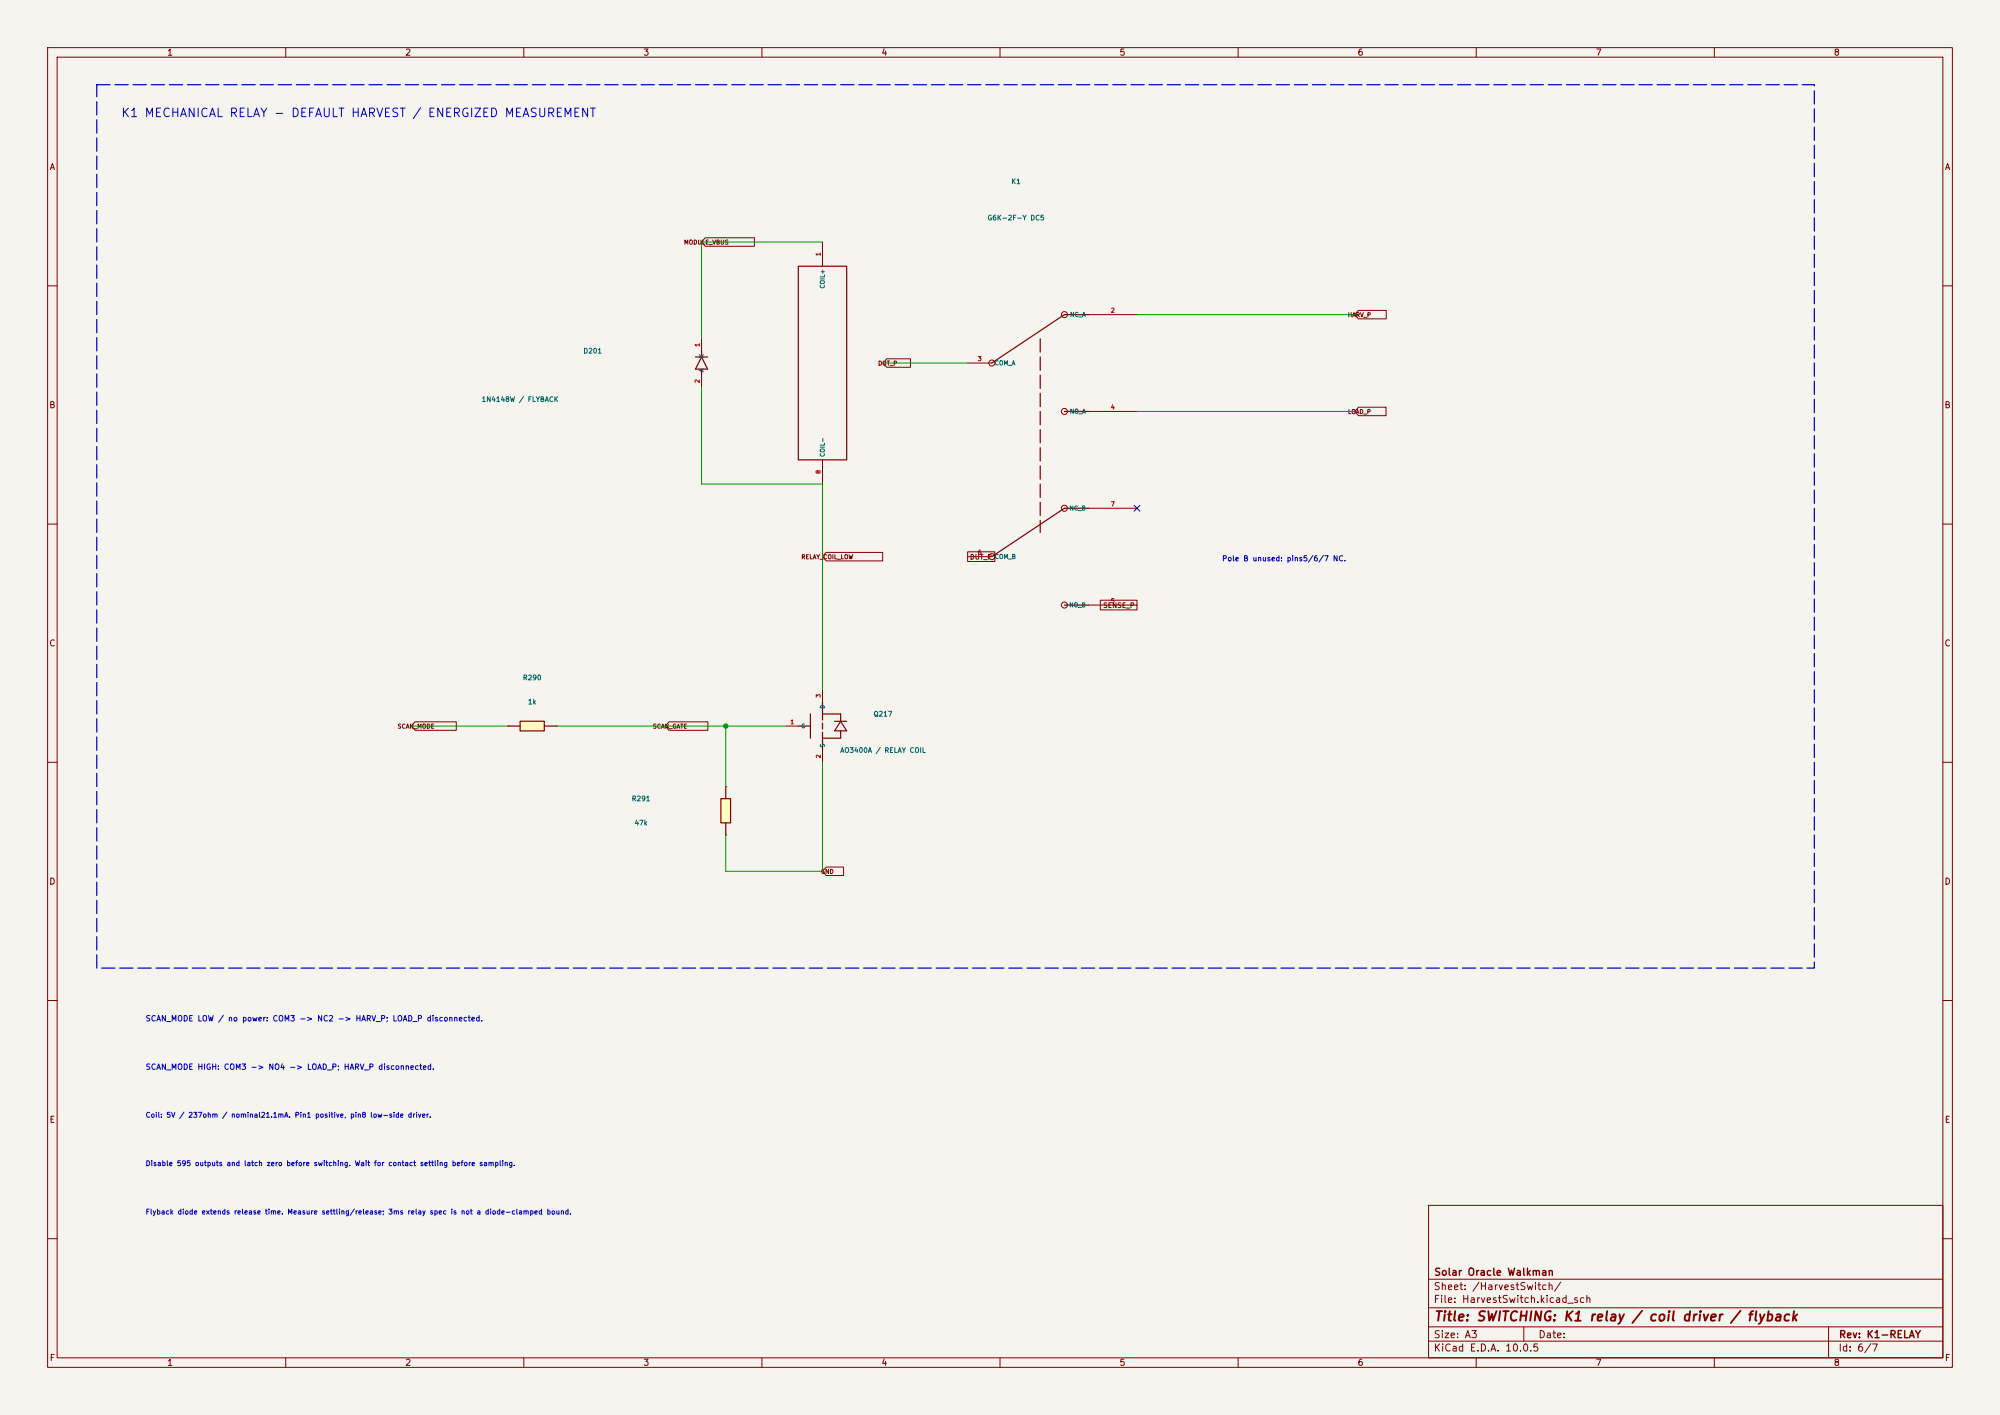
[picture p13: page 6]

K1 MECHANICAL RELAY - DEFAULT HARVEST / ENERGIZED MEASUREMENT

Disable 595 outputs and latch zero before switching. Wait for contact settling before sampling. SCAN_MODE LOW / no power: COM3 -> NC2 -> HARV_P; LOAD_P disconnected.

Coil: 5V / 237ohm / nominal21.1mA. Pin1 positive, pin8 low-side driver. Flyback diode extends release time. Measure settling/release; 3ms relay spec is not a diode-clamped bound. SCAN_MODE HIGH: COM3 -> NO4 -> LOAD_P; HARV_P disconnected.

Solar Oracle Walkman
Sheet: /HarvestSwitch/
File: HarvestSwitch.kicad_sch
Title: SWITCHING: K1 relay / coil driver / flyback

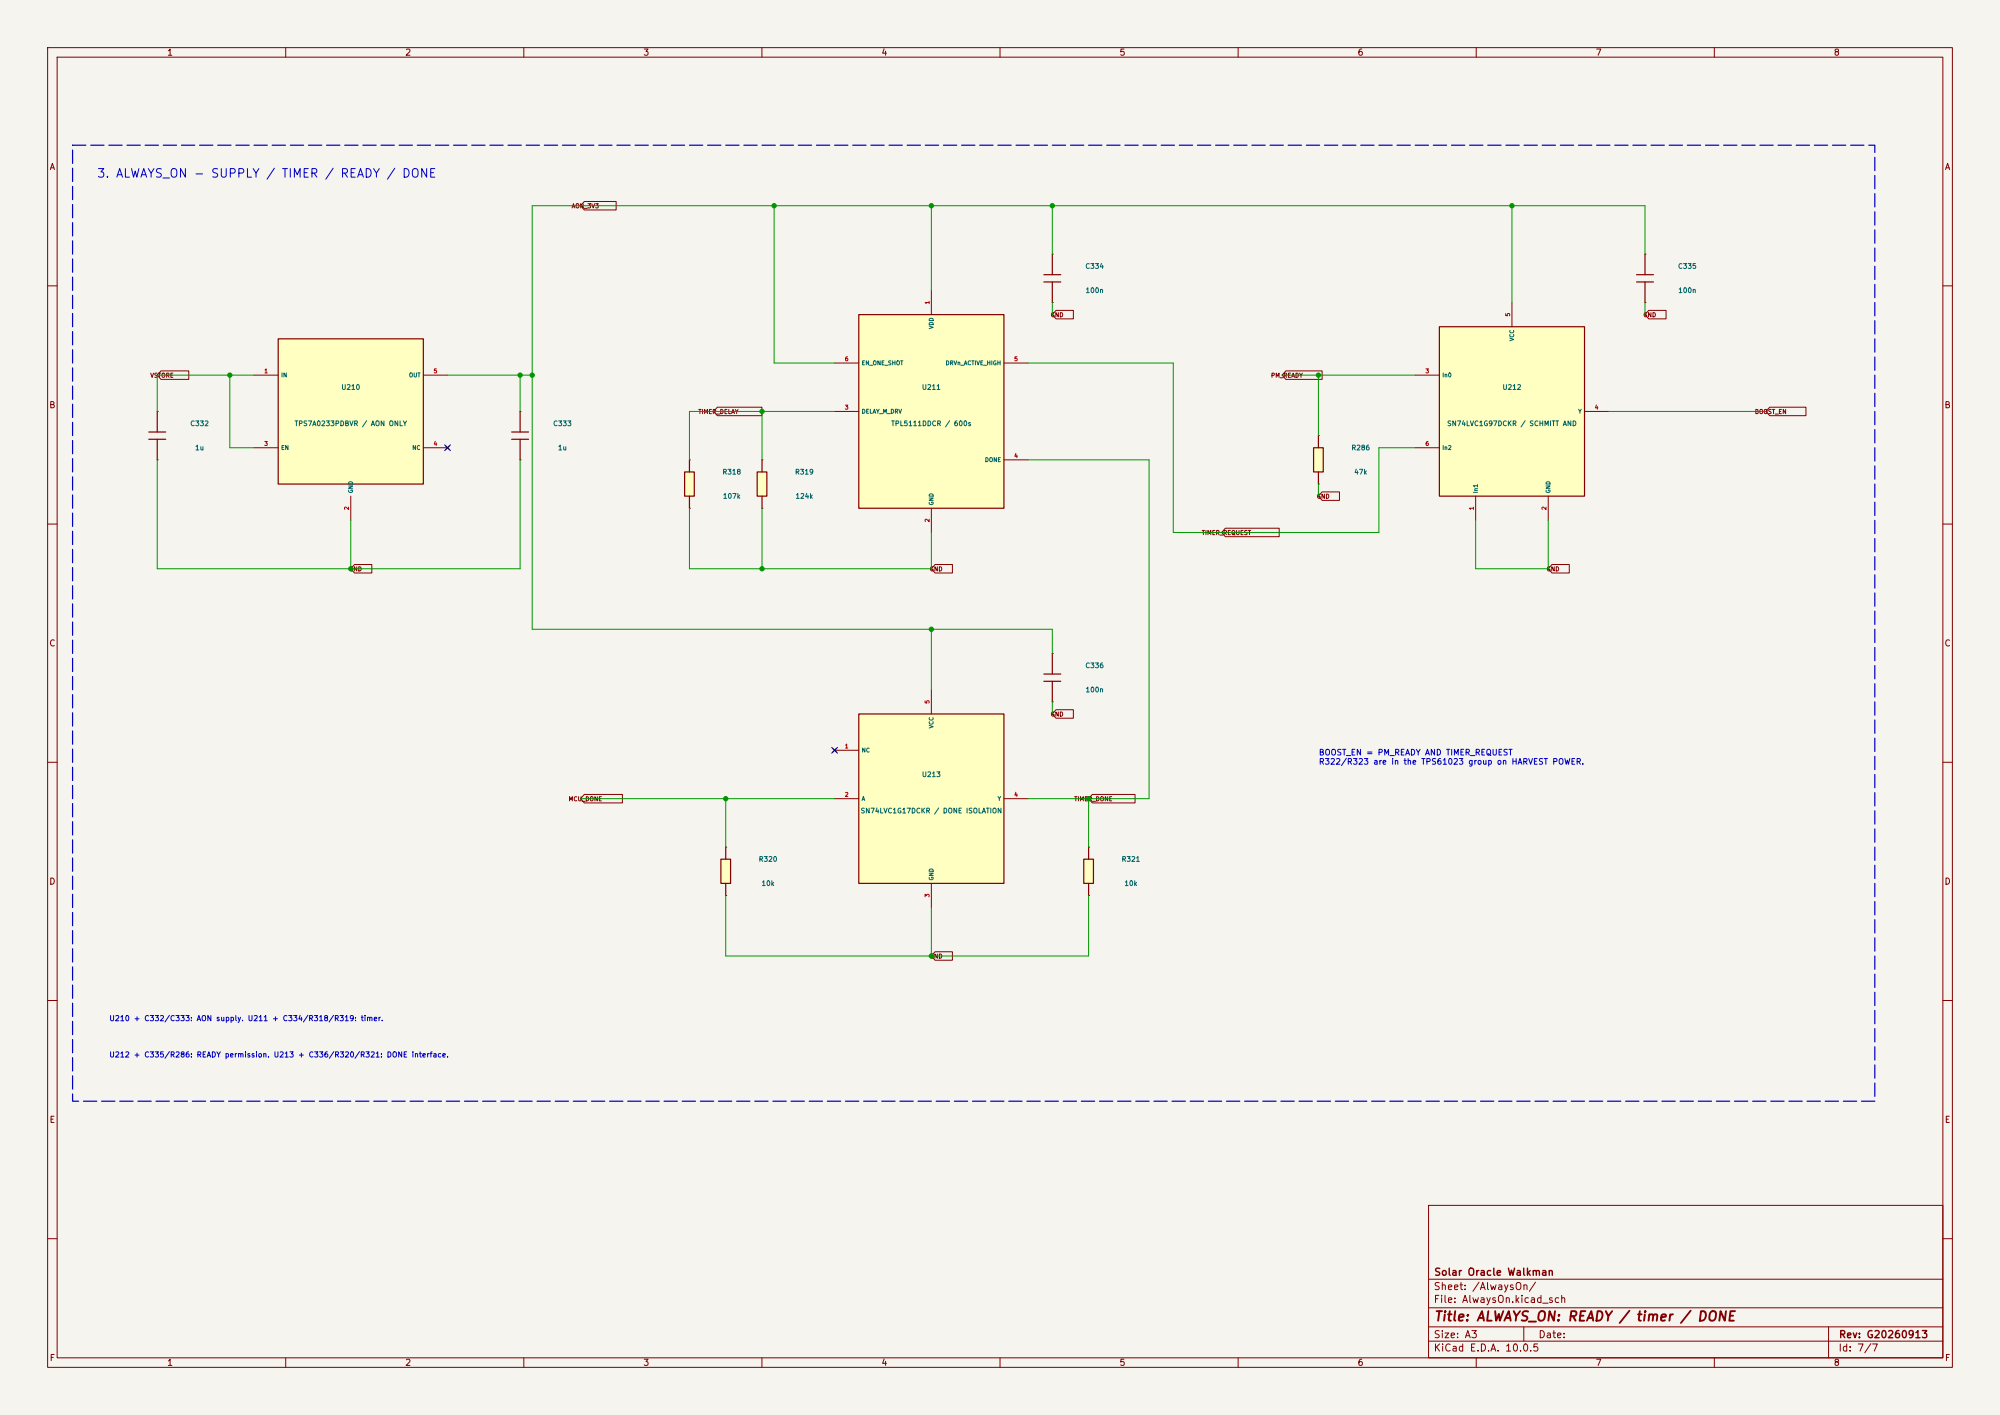
[picture p14: page 7]

3. ALWAYS_ON - SUPPLY / TIMER / READY / DONE

Solar Oracle Walkman
Sheet: /AlwaysOn/
File: AlwaysOn.kicad_sch
Title: ALWAYS_ON: READY / timer / DONE
