weiweiweiopen/IVcurve_tester/(commit log)

2026-08-03 Add routed IV curve carrier PCB
    [IVcurve-tester-carrier-r0.kicad_pcb, IVcurve-tester-carrier-r0.kicad_sch]
2026-10-28 Publish basic and charging IV curve tester hardware
    [ADG706BRUZ-REEL7.step, AlwaysOn.kicad_sch, BOM.csv, DisplayUI.kicad_sch, HarvestPower.kicad_sch, HarvestSwitch.kicad_sch, IVcurve-tester-carrier-r0.kicad_pcb, IVcurve-tester-carrier-r0.kicad_sch]
